nbourre/ranger_dropin/auriga/photos/PXL_20261021_132910721 (Custom).jpg

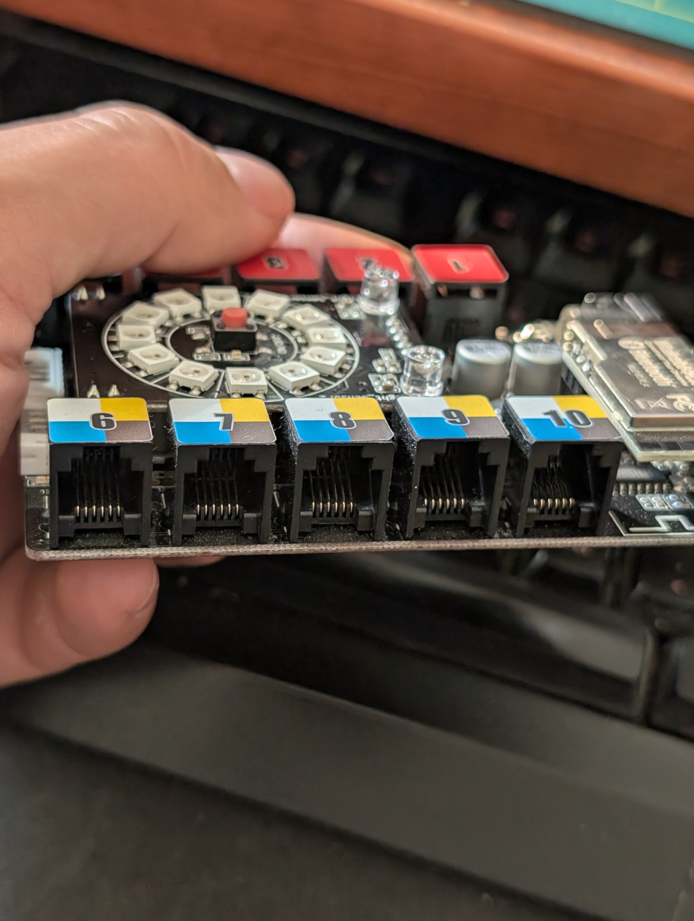
auriga/photos/PXL_20261021_132910721 (Custom).jpg
