nbourre/ranger_dropin/auriga/photos/PXL_20261021_135851345 (Custom).jpg

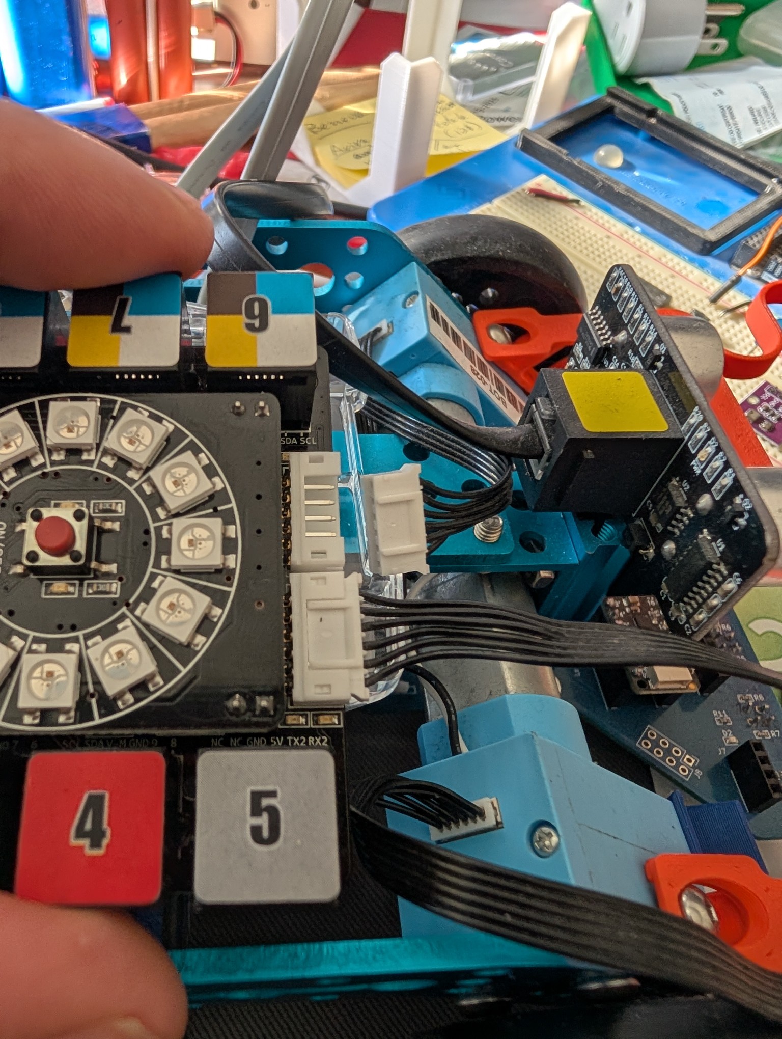
auriga/photos/PXL_20261021_135851345 (Custom).jpg
