nbourre/ranger_dropin/memoire/notes-a-faire.md

# À faire / en suspens (Beaper-Esp32s3, carrier DevKitC-1)

Dernière mise à jour : 2026-10-28 (soir). **L'état fait foi dans `MEMOIRE.md`, section « État (2026-10-28) »** ; les positions de la section « Disposition actuelle » ci-dessous datent du 2026-10-22 et sont en partie périmées (U5 tourné de 180° avec broche 1 à droite, J4/J8/SW1 déplacés, plus de bande de protections à la même place). Pour les positions réelles, lire la carte. Historique détaillé : `checkpoints/` (001 à 005, Copilot) et `git log`.

**Prochaine session, dans l'ordre** : (1) valider dans git l'état actuel (U5 2x22, modèles 3D, outils) ; (2) régler les conflits Q7/D13 et C7/Q5 et le courtyard H1/H4/H7/H8 ; (3) **routage** (lignes moteur 1 A, I2C, 5V_P, VCC) puis **zones de masse sans cuivre sous l'antenne du DevKit (x > 104)** ; (4) ERC/DRC finaux, BOM/LCSC, modèles 3D restants ; (5) demander à l'utilisateur de mettre à jour les 19 empreintes restantes depuis la bibliothèque dans KiCad (modèles 3D décochés, sans U5).

## État du projet
- **Schéma** : à jour (buck, fusibles séparés, protection des sorties moteur, décalage de niveau des RJ25, J1 jack DC, M1/M2 en JST PH, Qwiic J8 et 3 headers I2C J9/J15/J16). Dernier ERC complet : 0 erreur (avant les derniers ajouts, **à relancer**).
- **PCB** : 127 empreintes synchronisées avec le schéma, **tout sur la face du dessus (F.Cu)**, placement fait à la main par l'utilisateur et optimisé (condensateurs et résistances près de leurs broches). **Pas encore routé, pas de zone de masse, DRC non repris sur la version finale.** `score_placement` = 60 (les seuls « échecs durs » restants sont des chevauchements voulus avec le DevKit U5 et quelques courtyards d'en-têtes, voir plus bas).
- Contour 65,5 × 100 mm (R2) de (50, 30) à (115,5, 130), 3 trous de guidage Ø 2 mm (GH1 88,75/36 ; GH2 105,5/113,5 ; GH3 60/113,5).

## Disposition actuelle (positions clés, mm, repère PCB)
- Haut : J1 jack DC (57,75; 41,1), SW1 reset (66,1; 32,15), J12 panneau RGB 1x7 (75,13 à 90,37; 32,6, centré en x), buck U1 (79,65; 47,98) avec L1, C13/C14/C15/C16, compensation C19/C20/R42, diviseur R40/R41 ; U3 TB6612 (69,95; 57,26) ; J5 RJ25 A (110,52; 42,64, ouverture vers le haut).
- Milieu : J13/J14 appuis GND du panneau (66,875 et 98,625; 75,1), colonne de headers H7/H8/H4/H1 (x = 108,17; y 57,7 à 68,2), J9/J15/J16 I2C 1x04 (x = 105,63; y 72,6 à 79,8), LS1 buzzer, J3 TFT (52,25; 47,1), J11 OLED (52,25; 71,1).
- Bas : DevKit U5 (60,53; 107,28, rot 90, sur supports) avec les petits composants dessous (y 84 à 107), J4 et J8 Qwiic (111,25; 100,1 et 91,6, ouverture vers le bord droit, **sous le DevKit**), bande y 109 à 118 : chaînes de protection moteur et résistances d'encodeur, J10 VL53L1X (76,4 à 89,1; 119,6), M1 (70,25; 123,4) et M2 (85,25; 123,4) en JST PH, J6 et J7 RJ25 B et C dans les coins du bas (103,15 et 56,06; 117,71, ouverture vers le bas).
- Fixes (contraintes de l'utilisateur) : connecteurs moteur M1/M2 et capteur de distance J10 (J10 a été remonté de 4,2 mm pour les JST). Le module RGB doit rester centré en x.

## Décisions de conception (rappel)
- **Alimentation** : batterie NiMH 7,2 V sur J1 (centre = VBAT). VBAT → TVS D9 → F1 3,5 A → D8 → VCC (moteurs, VM du TB6612) et F2 3 A → D13 → buck U1 TPS54331 (5,0 V, même circuit que l'Auriga). D11 isole la sortie du buck (5V_P) du rail +5V (≈4,7 V) pour éviter le retour de courant USB. Servos : micro 9 g, 2 sorties (H7 = A6 / GPIO 6, H8 = A7 / GPIO 7) via le 74HCT541 U2 ; générer le PWM par LEDC.
- **Sorties moteur** : TB6612 → TVS bidirectionnelle SMAJ12CA (D14 à D17) → perle 120 Ω/2 A (FB1 à FB4) → PTC 1 A (F3 à F6) → M1/M2. Chaînes placées juste au-dessus de M1/M2.
- **M1/M2** : JST PH 6 broches, pas 2,0 mm, entrée latérale (S6B-PH-K, empreinte `Connector_JST:JST_PH_S6B-PH-K_1x06_P2.00mm_Horizontal`, modèle 3D de KiCad). Photos de l'Auriga dans `auriga/photos/`. Brochage : 1 ENCB, 2 ENCA, 3 +3V3, 4 GND, 5 M−, 6 M+. **Sens de la broche 1 à vérifier au multimètre sur une fiche moteur réelle.** Les encodeurs sont en 3,3 V (Auriga : 5 V) : à tester, sinon diviseur.
- **RJ25 (J5, J6, J7)** identiques à l'Auriga en tension (5 V) : 6 signaux S1/S2 par décalage de niveau BSS138 (Q3 à Q8, pull-ups 10 k R45 à R56), nets côté port `PA_S1_5V` etc., alimentation sur `5V_P` (sortie du buck avant D11). Ordre des broches du RJ : 1 SCL, 2 SDA, 3 GND, 4 5 V, 5 S1, 6 S2. Numérique seulement (pas d'analogique 0-5 V) ; le port B partage GPIO 43/44 (UART0) ; le port C partage D9/D10 avec J3. Prise : Amphenol 54601-906WPLF (6p6c, « tab down », contacts en haut ; l'Auriga est l'inverse, le câble se tord sans problème).
- **JP1** (header 1x03, « I2C EXT 3V3/5V ») : choisit la tension des pull-ups du bus I2C des RJ25 (EXT_SCL/EXT_SDA) : 1-2 = 3,3 V, 2-3 = 5 V (position Makeblock). Sans rapport avec le « JP1 » (jack d'alimentation) de `AURIGA_PINMAP.md`.
- **I2C 3,3 V du carrier** : Qwiic J4 et J8 (JST SH, GND/3V3/SDA/SCL), headers J9/J15/J16 (GND, +3V3, SCL, SDA, comme J11), H1 (SDA) et H4 (SCL), J10, J11, U6. Aucun pull-up ajouté pour les nouveaux connecteurs ; **vérifier que les pull-ups du bus principal (R16/R17 4,7 k) suffisent avec 8 appareils**.
- **74AHCT1G125 (U7)** : tampon 3,3 V → 5 V pour la donnée de l'anneau RGB : GPIO 48 → U7 → R39 220 Ω → J12.5. KEY du panneau : actif haut, R38 15 k / R37 10 k vers GPIO 14, sans pull-up interne.
- **Condensateurs** : replacés près de leur circuit (buck, U3, U2, U7, U4, U6, U5). C11 est collé à la broche VOL_BAT du DevKit. C8 (470 µF, VCC) est resté loin de U3.
- **Remplacements d'empreintes** pour gagner de la place : C7/C8/C17 en CP_Elec_6.3x7.7 (C5354997), C3 en 1206, U2 en TSSOP-20 (C53552921), U4 en SOT-23 (C127949).
- Supprimés : CON1 (bornier), H2/H3 (sonar), H5/H6, R13/R14, R27/R28, SW2 à SW5. Le Qwiic J9 de l'ancien schéma n'existe plus : **J9 est maintenant un header I2C 1x04**.

## À faire (priorité)
1. **Relancer ERC et DRC** sur le fichier enregistré. DRC connu : sérigraphie des références qui se chevauche partout (les masquer ou les réduire), espacement des pastilles du LSM6 (U6, 0,15 mm pour 0,2 mm requis, propre au composant), courtyards du DevKit (à ignorer ou exclure).
2. **Routage** (Freerouting ou à la main) : lignes moteur 1 A longues (U3 en haut, M1/M2 en bas, ~60 mm), I2C, 5V_P, VCC ; **zones de masse** F.Cu/B.Cu.
3. **Vérifications en 3D** (Alt+3) : RJ25 (ouverture qui dépasse du bord de ≈ 4,5 mm pour J5, J6 et J7, l'Auriga dépasse de ≈ 1,8 mm), Qwiic J4/J8 sous le DevKit (câble qui doit entrer sous le module), hauteur sous le DevKit (8,5 mm) et sous le module panneau, J12 contre GH1, buzzer LS1, SW1 (orientation du bouton latéral), J1 (sens d'entrée de la fiche).
4. **Modèles 3D** (état 2026-10-28) : U5 : modèle de l'utilisateur `3dmodels/ESP32-S3-DEVKITC-1-N8R8--3DModel-STEP-269445.STEP` (SolidWorks, mm, axe vertical = y, broches à x = ±11,43, z = −29,97 à 23,37, circuit y = 2,54 à 4,14, antenne côté z négatif) : rotation **x −90°** (le signe de KiCad est inversé : +90 donnait un modèle à l'envers), décalage **11,43 / −29,97 / 5,96** (dessous du circuit à 8,5 mm au-dessus de la carte) + deux supports `PinSocket_2x22_P2.54mm_Vertical` de KiCad aux décalages **0 et 25,4** (leur 2e colonne est vers les x négatifs). Validé par rendu 3D sur une carte d'essai (broches dans les supports, module côté broche 1, USB à l'autre bout). **Dans la bibliothèque seulement** : à copier sur la carte par « Mettre à jour les footprints depuis la bibliothèque » (option modèles 3D cochée) ou en les collant dans l'onglet 3D Models de U5. Les broches du modèle dépassent de 15 mm sous le circuit (plus long que les supports de 8,5 mm : c'est normal visuellement). L1 (Bourns SRP7028A) et SW1 (Alps SKRTLAE010) : KiCad ne fournit pas les fichiers que la carte référence ; blocs **approximatifs** générés par `tools/make_block_models.py` dans `3dmodels/*.wrl`, **pas encore assignés sur la carte** (propriétés du footprint, onglet Modèles 3D, échelle 1). À remplacer par les vrais STEP du fabricant. Reste sans modèle : G1 (logo) et GH1 à GH3 (trous, normal). Les autres empreintes ont un modèle de KiCad : si les modèles manquent après un rechargement, faire « Mettre à jour les empreintes depuis la bibliothèque » dans KiCad.
5. **Placement à revoir si le routage coince** : U3 plus près de M1/M2 ; D10 (diode du buck) à 4,8 mm de la broche PH de U1 (acceptable) ; C13 à 6 mm de VIN ; H1/H4/H7/H8 se touchent de 0,3 mm (courtyards) ; F6/LS1 1,2 mm² ; J12/GH1 2,8 mm² (pas de contact cuivre).
6. LCSC / BOM : refs manquantes (F1, D8, D9, C8, R31 à R39, R45 à R56 = 10 k C25804, C9 à C12, M1/M2 S6B-PH-K-S, U7, RJ25 54601-906WPLF, Qwiic, supports). L1 = HCMA-0630-6R8 (C54431702, Extended) à confirmer ; C7/C8/C17 470 µF C18221527 / C5354997 à confirmer.
7. Datasheet du LSM6DS3TR-C absent (st.com bloque le téléchargement automatique). Autres datasheets dans `datasheets/`.
8. Ménage du schéma : cadre pointillé « Optional 5V LDO » vide et périmé (x 25-86, y 150-193 mm) avec D1/R2 (LED Vin) ; commentaire 3 de la page de titre qui dit encore « Arduino Nano ESP32 ».
9. Confirmer le brochage du module OLED (J11 supposé GND, 3V3, SCL, SDA) et l'ordre des broches des modules I2C génériques (J9/J15/J16 sont GND, VCC, SCL, SDA).
10. Mesurer les trous de fixation Makeblock sur une vraie poutre (nominal 8 mm, M4).
11. **[Mise à jour 2026-10-28, soir : U5 tourné de 180° par l'utilisateur (rotation −90°, origine (113,87 ; 84,42), broche 1 à DROITE) pour que les USB soient à gauche (x ≈ 52,1, dans la carte) et l'antenne dépasse à droite (≈ 6 mm au-delà du bord) ; rangée L = nord (y 84,42, accès 81,88), rangée R = sud (y 107,28, accès 109,82). Étiquettes de broches refaites (44, y = 87,0 et 104,8). Les pièces liées aux GPIO sont à replacer par l'utilisateur.]** **[FAIT 2026-10-28 : footprint, schéma et carte à jour, cavaliers actifs sur la carte (`duplicate_pad_numbers_are_jumpers yes`), DRC non routés revenus à 304 ; pièces replacées par l'utilisateur ; il reste seulement à décider si on étiquette les rangées d'accès]** Historique : footprint créé : `BEAPER-Nano:ESP32-S3-DevKitC-1-2x22`** (88 pastilles, rangée d'accès **à l'extérieur** à x = −2,54 et 25,4 dans le repère du footprint, c'est-à-dire y = 109,82 et 81,88 mm sur la carte avec U5 en (60,53 ; 107,28) rot 90 ; même numéro de pastille que la broche du DevKit ; courtyard 30,6 × 56 mm). **Reste** : (1) cocher « Les numéros de pastille en double sont des cavaliers » (*duplicate_pad_numbers_are_jumpers*) dans les propriétés du footprint, Konnect ne peut pas l'écrire ; (2) changer le champ Footprint de U5 dans le schéma (le schéma doit être fermé dans l'éditeur) ; (3) mettre à jour le PCB depuis le schéma (dry-run d'abord) ; (4) l'utilisateur replace les pièces autour de la nouvelle rangée (la rangée sud tombe sur la bande des protections moteur, la rangée nord près de J9/J13/J14) ; (5) refaire les étiquettes des broches si besoin. Demande d'origine : **Monter le DevKit (U5) sur des headers femelles « doubles » : 2x22 au lieu de 1x22 par côté** (demande de l'utilisateur, 2026-10-22, à faire **avant** la tâche 12). Chaque côté du DevKit aurait donc deux rangées de 22 contacts femelles à 2,54 mm : une rangée reçoit les broches du DevKit, l'autre rangée, reliée broche à broche en parallèle, donne accès à **toutes** les broches (mesure, fils Dupont, autres variantes, GPIO non câblés). Pistes à étudier : (a) une empreinte U5 personnalisée (p. ex. `BEAPER-Nano:ESP32-S3-DevKitC-1-2x22`) avec deux pastilles du même numéro par broche, pour ne pas toucher au schéma, ou deux `PinSocket_2x22_P2.54mm_Vertical` ; (b) rangée supplémentaire **à l'extérieur** (côté bord de la carte), pour ne pas manger la zone entre les rangées où passent les petits composants ; (c) vérifier la largeur : DevKit 22,86 mm + 2 × 2,54 mm de rangée supplémentaire, sur une carte de 65,5 mm, et le chevauchement avec J3/J11 (x ≈ 52 mm) et la colonne H (x ≈ 105-113 mm) ; (d) la hauteur sous le module panneau (limite ≈ 8,5 mm sous le DevKit, à revalider) ; (e) les pastilles de la rangée supplémentaire doivent avoir un net (celui de la broche), même si elles ne vont nulle part ailleurs. Si toutes les broches sont accessibles ainsi, la tâche 12 devient en grande partie inutile.
12. **Ajouter des headers de sortie pour les GPIO 35, 36 et 37** (demande de l'utilisateur, 2026-10-22). Ces trois broches sont réservées par la **PSRAM octale** (« R8 ») : c'est le type de PSRAM qui compte, pas la taille de la mémoire. La taille de la flash (N8 ou N16) ne libère aucune broche.

    | Variante du DevKitC-1 (même empreinte) | Flash | PSRAM | GPIO 35/36/37 |
    |---|---|---|---|
    | N16R8 (celle de la carte) | 16 Mo | 8 Mo octale | réservés |
    | N8R8 | 8 Mo | 8 Mo octale | réservés |
    | N8R2 | 8 Mo | 2 Mo quad | libres |
    | N8 / N4 | 8 ou 4 Mo | aucune | libres |

    Les flash octales (type N32R8V) en réservent encore plus. Tableau tiré de mes connaissances du module : **à confirmer** dans la fiche d'Espressif (WROOM-1, tableau des broches) et `datasheets/U5_ESP32-S3-DevKitC-1_schematic.pdf`. À faire : un header 1x03 (GPIO 35/36/37) avec les nets nommés, non câblés à autre chose, marqué « sans PSRAM octale seulement » en sérigraphie (inutile avec un N16R8 ou un N8R8) ; mettre à jour le tableau GPIO du README si on les utilise.
13. Optionnel : MCP23017 si plus de GPIO ; firmware : GPIO 14 (KEY) en entrée sans pull-up interne, actif haut ; module suiveur de ligne I2C maison (ATtiny1616 seesaw, adresse 0x49) sur un Qwiic.

## Améliorations à regarder plus tard
- **Remplacer les 6 canaux BSS138 des RJ25 (Q3 à Q8, pull-ups R45 à R56) par un TXS0108EPW** (demande de l'utilisateur, 2026-10-28). Gain : 18 composants (6 FET + 12 résistances) remplacés par 1 TSSOP-20 + 2 condensateurs de découplage ; 8 canaux, donc 2 de réserve ; A = 3,3 V (1,65 à 3,6 V), B = 5V_P (2,3 à 5,5 V). Réserves (tiré de mes connaissances du composant, **à confirmer dans la fiche TI**) : (a) pas de pull-ups sous ≈ 50 kΩ avec le TXS (les 10 k disparaîtraient) ; (b) la détection automatique de direction peut mal gérer les capteurs Makeblock bidirectionnels sur une seule broche (ultrason) ou à collecteur ouvert, là où BSS138 + pull-ups sont fiables ; (c) risque de parasites ou d'oscillations avec la capacité des câbles RJ25 ; (d) broche OE à contrôler (basse à la mise sous tension), VCCA ≤ VCCB en tout temps. À tester avec les capteurs réels avant de s'engager. Le bus I2C EXT (JP1) est séparé et ne serait pas touché.

## Pièges Konnect appris
- Voir `MEMOIRE.md`, section « Particularités des outils Konnect ».
