nbourre/ranger_dropin/memoire/checkpoints/001-auriga-motor-power-comparison.md

<overview>
The user is converting a KiCad 10 project (BEAPER Nano, a mirobo.tech educational robot board) from through-hole to SMD parts, using JLCPCB/LCSC Basic parts where possible. The final board will be a carrier for an **ESP32-S3-DevKitC-1-N16R8** that replaces the Makeblock mBot Ranger's Arduino "Auriga" controller. The user's latest request (in French) is to make sure the motor power available on the Beaper is **at least similar to the Auriga's**. I'm comparing the two schematics and am about to swap the motor driver in the schematic. The PCB layout is deferred until the user provides dimensions. The user writes in French, so reply in French.
</overview>

<history>
1. The user asked for help with the Konnect MCP configuration and attached `file_mcp.json`.
   - The file registers `KiCAD-MCP-Konnect` as a stdio server at `C:\Users\nicol\OneDrive\Documents2\KiCad\10.0\3rdparty\plugins\com_github_mixelpixx_konnect\bin\konnect.exe`.
   - I confirmed Konnect responds (v0.13.0, KiCad CLI 10.0.7, IPC socket available).
   - Via `load_toolset` I loaded all 21 toolsets (228 tools).
   - I explained that Konnect's Claude skill files in `~/.claude` are not auto-installed for Copilot; I use the MCP tools directly.

2. The user asked to replace the through-hole parts with Basic SMD parts, schematic first, PCB dimensions later. The goal is to replace the Arduino Auriga with an ESP32-S3.
   - I inspected the project: 140 components.
   - I asked clarifying questions. The user's answers:
     - Ignore the ESP32-S3 for now and migrate the simple components to SMD.
     - Keep all original functionality.
     - Basic parts preferred.
     - Keep THT connectors.
     - The target is a carrier board for the DevKitC-1-N16R8.
   - I downloaded the JLCPCB parts database to `C:\Users\nicol\AppData\Local\Temp\konnect-jlcpcb-parts.sqlite` (Konnect's own search tool reports no DB path configured in `settings.json`). I checked Basic availability, then deleted the DB.
   - I used `batch_edit_schematic_components` to set footprints in `BEAPER-Nano.kicad_sch`:
     - R1–R30 → `Resistor_SMD:R_0603_1608Metric`
     - C4, C5, C6 (100 nF) → `Capacitor_SMD:C_0402_1005Metric`
     - D1–D5 → `LED_SMD:LED_0603_1608Metric`
   - Verified: 140 components preserved, all pin-to-net mappings identical, 38/38 footprints applied.
   - Left the 10 µF polarized caps (C1, C2, C3, C7) THT because of LM2940 stability concerns. D6/D7 (5 mm LEDs), Q1–Q4 (optical), SW1–SW5, RV1/RV2, JP1–JP4, buzzer, all headers/CON1, U1 (TO-220), U2 (DIP-20), U3 (DIP-16), U4 (TO-92) are all still THT.
   - Basic-part findings:
     - 0603 Basic resistors exist for 100R (C22775), 270R (C22966), 1k (C21190), 4.7k (C23162) and 10k (C25804).
     - 5.62k (C2930113 / C23188) and 1.37k (C2933142 / C22839) are Extended only.
     - 100 nF 0402 X7R: C1525 (16 V) or C307331 (50 V).
     - LED KT-0603R is C2286.
     - 10 µF options: 0603 C19702 (Basic), 0805 C15850 (Basic).

3. The user said they added the Auriga schematic and asked (in French) to make sure the Beaper's motor power is at least similar to the Auriga's.
   - Found `Me Auriga Schematic.pdf` in the project root (1 page, 842×595 pt). I extracted the text and rendered crops with PyMuPDF to `…\session-state\…\files\auriga_motor.png`, `auriga_power_a.png` and `auriga_power_b.png`.
   - Analysed the Beaper motor circuit by exporting a netlist (`files\beaper.net`) and a render (`files\beaper_before.png`).
   - Backed up the current schematic to `C:\Users\nicol\.copilot\session-state\41f4b332-d886-444f-8613-d4b14432f684\files\BEAPER-Nano.kicad_sch.before-tb6612`.
   - Re-downloaded the JLC DB (temp path above; it must be deleted again) and confirmed TB6612FNG availability.
   - Was in the middle of planning the U3 replacement when compaction occurred. **No U3-swap edits have been made yet.**
</history>

<work_done>
Files modified:
- `D:\_data\projets\_cegep\1sx\ranger_dropin\BEAPER-Nano.kicad_sch`: footprint changes only, as listed in the history.

Files created (session artifacts, in `C:\Users\nicol\.copilot\session-state\41f4b332-d886-444f-8613-d4b14432f684\files\`):
- `BEAPER-Nano.kicad_sch.before-tb6612` (backup)
- `beaper.net`
- `beaper_before.png`
- `auriga_motor.png`
- `auriga_power_a.png`
- `auriga_power_b.png`

Temp file to delete: `C:\Users\nicol\AppData\Local\Temp\konnect-jlcpcb-parts.sqlite` (~335 MB).

Work completed:
- [x] Konnect access verified and all toolsets loaded
- [x] Passive/LED footprints migrated to SMD in the schematic
- [x] Auriga motor and power section analysed
- [x] Beaper motor driver wiring traced from the netlist
- [x] TB6612FNG symbol and JLC part located
- [ ] Replace U3 (SN754410, DIP-16) with a TB6612FNG in the schematic (planned, not started)
- [ ] Delete the temp JLC DB
- [ ] Report findings to the user in French (comparison, change made, caveats)

Pre-existing uncommitted git changes that are not mine: `BEAPER-Nano.kicad_pcb` (modified, currently open in KiCad), `BEAPER-Nano.kicad_pro`, `.mcp.json`, `.vscode/`.
</work_done>

<technical_details>
**Auriga motor section (from PDF):**
- Driver is a Toshiba **TB6612** (U4).
  - VM pins 13, 14 and 24.
  - Logic VCC is 5 V.
  - STBY, PWMA and PWMB are driven by the MCU (EN_PWMA/B, EN_DIRA1/2, EN_DIRB1/2).
  - Outputs AO1/AO2 and BO1/BO2 go to M1+/M1−/M2+/M2−.
- Motor supply `V-M` comes from V-BAT through diode D06 (SS54) and fuse F02 (3.5 A). Each motor output has a 1 A fuse (F3, F4) and BEAD,2A filters.
- SMAJ12A TVS diodes are on the motor outputs. A SMAJ13A TVS is on the battery input.
- VM bulk capacitance: 470 µF/16 V plus 10 µF and 100 nF caps.
- Main V-BAT input has a 1.5 A fuse (F1) and an SS34 diode.
- 5 V comes from a TPS54331 buck converter.

**TB6612FNG characteristics:**
- 1.2 A continuous / 3.2 A peak per channel.
- About 0.5 Ω total on-resistance, so roughly 0.5 V drop at 1 A.
- VM range 4.5–13.5 V.
- Logic VCC 2.7–5.5 V.

**Beaper motor section (from netlist and render):**
- U3 = SN754410NE:
  - Pin 8 (VCC2) = net `VCC` (battery, labelled "6–12 V" on CON1); pin 16 (VCC1) = `+5V` (from the LM2940 U1).
  - Pins 1 and 9 (enables) are tied together and pulled to +5V via R19 (10k), so always enabled; there is no PWM-on-enable.
  - Inputs 1A–4A (pins 2, 7, 10, 15) come from 74HCT541 (U2) outputs Y4–Y7, which come from D4–D7.
  - Outputs 1Y–4Y (pins 3, 6, 11, 14) go to CON1 pins 3–6 (M1A, M1B, M2A, M2B).
  - GND on pins 4, 5, 12 and 13.
  - CON1: pin 1 = VCC, pin 2 = GND.
  - There is no fuse, reverse-polarity diode or TVS, and only 2× 10 µF polarized caps on VCC.
- The SN754410 is rated 1 A continuous / 2 A peak per bridge, but it is a bipolar driver with about 1.4 V (source) + 1.2 V (sink) ≈ 2.6 V typical drop at 1 A (up to about 3.6 V). At a 7.4 V battery that leaves about 4.8 V at the motor versus about 6.9 V with the TB6612. It also dissipates about 2.6 W per bridge, so it is clearly weaker and hotter than the Auriga's.

**Planned fix (U3 → TB6612FNG):**
- Symbol: `Driver_Motor:TB6612FNG`, footprint `Package_SO:SSOP-24_5.3x8.2mm_P0.65mm`, JLC part C141517 (Extended, about $1.15, 3,100+ in stock; C88224 is an alternate SSOP-24).
- Symbol pin offsets (symbol y is up, schematic y is down):

| Pin | x offset | y offset |
|---|---|---|
| AIN1 | −15.24 | −2.54 |
| AIN2 | −15.24 | −5.08 |
| BIN1 | −15.24 | −7.62 |
| BIN2 | −15.24 | −10.16 |
| PWMA | −15.24 | +5.08 |
| PWMB | −15.24 | +2.54 |
| STBY | −15.24 | +10.16 |
| AO1 | +15.24 | +10.16 |
| AO2 | +15.24 | +5.08 |
| BO1 | +15.24 | −2.54 |
| BO2 | +15.24 | −7.62 |
| VM1/VM2/VM3 | +2.54 / +5.08 / +7.62 | +25.4 (top) |
| VCC | −7.62 | +25.4 (top) |
| PGND1 | +2.54 | −25.4 (bottom) |
| PGND2 | +7.62 | −25.4 (bottom) |
| GND | −7.62 | −25.4 (bottom) |

- Pins 1/2, 3/4, 5/6, 7/8, 9/10 and 11/12 are stacked duplicates at the same location.
- Mapping to preserve behaviour:
  - AIN1 ← Y4 (D4), AIN2 ← Y5 (D5), BIN1 ← Y6 (D6), BIN2 ← Y7 (D7).
  - AO1 → CON1.3, AO2 → CON1.4, BO1 → CON1.5, BO2 → CON1.6.
  - PWMA and PWMB tied to +5V.
  - STBY to the R19 pull-up net.
  - VCC = +5V; VM1/2/3 = `VCC` rail; GND/PGND1/PGND2 = GND.
- Behavioural difference to flag to the user: with both inputs low the TB6612 coasts (high-Z), while the SN754410 brakes. IN=H/H brakes on both.
- The TB6612 VM max is 13.5 V, so the supply must stay ≤ 12 V (the Beaper label says 6–12 V, which is OK). The SN754410 tolerated up to 36 V.
- Optional improvements to recommend (not necessarily implement): reverse-polarity SS54 (JLC Basic C22452), a 3.5 A fuse, SMAJ13A TVS (C19077533), and a 470 µF/16 V VM bulk cap, all to match the Auriga.

**Geometry plan for the swap** (schematic mm; sheet is size B and the motor block is a dashed box at roughly x 227–314, y 183–247):
- Old U3 center is (262.89, 223.52).
- Old input wires from U2 Y4–Y7 (starting at x=135.89) end at x=247.65 at y 218.44, 220.98, 228.6, 231.14, with intermediate jogs at x 231.14 and 233.68.
- Old output stubs end at x=278.13 and run to CON1 pins at x=290.83, y 220.98, 223.52, 226.06, 228.6.
- The VCC rail is at y=195.58; the +5V rail runs along y=195.58 from x 237–260.
- R19 is at (237.49, 200.66) with its enable bus down x=237.49.
- Wire UUIDs to delete (first 8 characters; full UUIDs come from `list_schematic_wires`):
  - input side: 2cb46060, 22d97baf, 2abbdc26, 84f44523, d2b3e968, 2506886c, b7d0d5e7, 698f16b4, c94594ca, 619f957e, 60bd4e13, d40c62d1
  - output side: dc6c2a71, 5197c9a3, 0b00909e, 4f70a452
  - power/GND stubs: 377177fa (old VCC2), 6ff15d8c (old VCC1), 3f83757f (old GND stub)
  - Also delete the GND power symbol at about (262.89, 238.76).
- Wires to keep: 25e7df82 and b84e747b (CON1 side), 4e18d0c2 and 4e96cad3 (straight output stubs to CON1.5 and CON1.6).
- Proposed placement: cx=260.35, cy=236.22.
  - VM2 lands at (265.43, 210.82), which reuses the existing VCC wire 377177fa up to the rail.
  - Tie VM1 and VM3 with a horizontal wire at y=210.82 from x 262.89 to 267.97.
  - The +5V wire for the VCC pin goes up at x=252.73 to the +5V rail at y=195.58, with a junction.
- The dashed "Optional robot motor driver" rectangle (bottom ≈ y 247) is too small. Either extend its bottom edge to about y 266 by editing the `(rectangle …)` entry in the .kicad_sch text, or accept overflow.
- Because the old wires are unnamed (`Net-(…)`), the simplest and cleanest wiring is net labels on matching wire/pin ends:
  - Labels for the outputs: M1A, M1B, M2A, M2B.
  - Labels for the inputs: e.g. M1_IN1, M1_IN2, M2_IN1, M2_IN2 (at the Y4–Y7 wire ends and at the TB6612 pins).
  - Label for STBY: e.g. MOTOR_STBY (at R19 pin 2 and at the STBY pin).
  - Use power symbols (`add_power_symbol`) for +5V (PWMA/PWMB, VCC) and GND, not local labels, to avoid the root-sheet "/" net-name prefix ambiguity.
- Add a custom field `LCSC = C141517` to the new U3.

**Konnect tool quirks:**
- Tools are deferred and must be surfaced via `tool_search_tool` before use. Just surfaced: `add_schematic_net_label`, `batch_delete`, `batch_connect_to_net`, `batch_delete_schematic_wire`, `delete_schematic_net_label`. Still to surface: `add_schematic_component`, `add_wire`, `add_power_symbol`, `add_junction`.
- `export_netlist_summary` reports unnamed nets as "~".
- `generate_netlist` (kicad-cli) produces real net names as `Net-(U3-…)`; its KiCad 10 format is multi-line and needs an S-expression parser (the regex attempt failed).
- `get_symbol_info` requires the `lib_id` argument.
- `download_jlcpcb_database` fails without `output_path` ("path not found"), so pass an explicit temp path.
- `search_jlcpcb_parts` won't use the downloaded DB because `jlcpcb_db_path` is empty in `settings.json`, so query the SQLite directly with Python. Table `components` has columns LCSC, MFR_Part, Package, Manufacturer, Library_Type (Basic/Preferred/Extended), Description, Datasheet, Price, Stock, Category. Print with `sys.stdout.reconfigure(encoding='utf-8')` because of the ℃/Ω characters.
- The PCB is open in KiCad (IPC active). Schematic file edits went through fine earlier.
- The user's default passives (Konnect config): 100 nF 0402, 10 µF 0805, 10k 0402 pull-up. Fab is JLCPCB, 2 layers, min trace/clearance 0.15 mm, min via drill 0.3 mm.

**Open questions and assumptions:**
- Actual battery voltage and motor stall current are unknown. I assume 6–12 V per the Beaper label, similar to the Auriga.
- The user said "basic preferred", so the TB6612's Extended status is an acceptable exception.
- The Beaper note says the 5 V rail from LM2940 (1 A) feeds U3/U2 logic; TB6612 logic current is negligible.
- PCB changes (footprint swap, trace widths ≥ ~1 mm for the motor/VCC path) are deferred until the user provides board dimensions.
</technical_details>

<important_files>
- `D:\_data\projets\_cegep\1sx\ranger_dropin\BEAPER-Nano.kicad_sch`
  - Main schematic (size B, 140 components) being migrated.
  - Footprints for R1–R30, C4–C6 and D1–D5 already changed to SMD.
  - Next: replace U3. The motor block is in the bottom-right dashed box (U3 center at 262.89, 223.52; CON1 at about 295.9, 220.98).
- `D:\_data\projets\_cegep\1sx\ranger_dropin\BEAPER-Nano.kicad_pcb`
  - Board, open in KiCad and modified by the user. Not touched; layout deferred.
- `D:\_data\projets\_cegep\1sx\ranger_dropin\Me Auriga Schematic.pdf`
  - Reference for the Auriga's TB6612 motor drive, fuses and power. The motor section is about x 60–500, y 430–560 and the power section about x 540–842, y 20–130 (PDF points).
- `C:\Users\nicol\.copilot\session-state\41f4b332-d886-444f-8613-d4b14432f684\files\` (session artifacts)
  - `BEAPER-Nano.kicad_sch.before-tb6612`: rollback backup.
  - `beaper.net`: netlist export.
  - `beaper_before.png`: render of the schematic before the swap.
  - `auriga_*.png`: Auriga crops.
- `D:\_data\projets\_cegep\1sx\ranger_dropin\.mcp.json` and `.vscode\mcp.json`
  - MCP server config (untracked).
</important_files>

<next_steps>
Remaining work:
1. Surface the remaining Konnect tools (`add_schematic_component`, `add_wire`, `add_power_symbol`, `add_junction`).
2. Perform the U3 swap in `BEAPER-Nano.kicad_sch`:
   - Delete U3 (`batch_delete` with `references: ["U3"]`).
   - Delete the listed stale wires and the GND power symbol at the old U3 position.
   - Place `Driver_Motor:TB6612FNG` as U3 at about (260.35, 236.22) with the SSOP-24 footprint and `LCSC = C141517`.
   - Wire or label it per the mapping above (inputs from Y4–Y7, outputs to CON1.3–6, VM to the VCC rail, VCC/PWMA/PWMB to +5V, STBY to R19, GND/PGND to GND).
   - Extend the dashed box if needed.
3. Verify with `generate_netlist` plus an S-expression parse: the 4 input nets, the 4 output nets to CON1, VM = `VCC`, logic VCC = `+5V`, all GNDs, and the STBY pull-up. Confirm no other component's nets changed, run `run_erc`, and render a PNG to check visually. If it goes wrong, restore from the `.before-tb6612` backup.
4. Delete `C:\Users\nicol\AppData\Local\Temp\konnect-jlcpcb-parts.sqlite`.
5. Reply to the user in French, concisely:
   - Auriga (TB6612, 1.2 A continuous, ~0.5 V drop, 1 A fuses) vs Beaper (SN754410, ~2.6 V drop, much less motor voltage and more heat).
   - The driver was replaced by the same chip as the Auriga, which is also SMD.
   - The brake-vs-coast difference.
   - The ≤12 V limit.
   - Optional protection (SS54, 3.5 A fuse, SMAJ13A, 470 µF bulk cap).
   - The PCB will need updating later (footprint, ≥1 mm motor traces).
   - Confirm the battery voltage and motor stall current.

Immediate next step: call `tool_search_tool` for `add_schematic_component`, `add_wire`, `add_power_symbol` and `add_junction`, then begin the deletion/placement sequence.
</next_steps>
