nbourre/ranger_dropin/memoire/checkpoints/002-swapping-nano-socket-for-esp32.md

<overview>
The user is converting a KiCad 10 project (BEAPER Nano, a mirobo.tech educational robot board) from through-hole to SMD parts, using JLCPCB/LCSC Basic parts where possible. The board becomes a carrier for an **ESP32-S3-DevKitC-1-N16R8** that replaces the Makeblock mBot Ranger's Arduino "Auriga" controller. I use the Konnect MCP tools (KiCAD-MCP-Konnect) to edit the schematic. The user writes in French, so reply in French, concisely. PCB layout is deferred until the user gives board dimensions.

The latest request is: "Es-tu capable de remplacer le footprint et le câblage par ce board?" The user attached a photo of the ESP32-S3-DevKitC-1 pinout. The aim is to replace the Arduino Nano ESP32 socket (J1/J2) in the schematic with this DevKitC-1 board, both the footprint and the wiring. I answered "yes" in principle and am partway through the work.
</overview>

<history>
1. **Konnect MCP configuration help.**
   - Verified Konnect works (v0.13.0, KiCad 10.0.7) and loaded all toolsets.

2. **Through-hole to SMD conversion, schematic first.**
   - The user answered my clarifying questions: ignore the ESP32 for now, keep all functionality, prefer Basic parts, keep THT connectors, target is a carrier board for the DevKitC-1.
   - Footprints set in `BEAPER-Nano.kicad_sch`: R1–R30 → R_0603; C4–C6 → C_0402; D1–D5 → LED_0603.
   - Still THT: 10 µF polarized caps (C1, C2, C3, C7), D6/D7, Q1–Q4, switches, pots, jumpers JP1–JP4, buzzer, headers, CON1, U1 (TO-220), U2 (DIP-20), U4 (TO-92).

3. **Motor power compared with the Auriga.**
   - Auriga uses a TB6612 (1.2 A continuous, ~0.5 V drop, 1 A fuses, 3.5 A fuse, SS54 diode, SMAJ TVS, 470 µF VM cap).
   - Beaper used an SN754410 (DIP-16): ~2.6 V drop, far weaker and hotter.
   - I replaced U3 with `Driver_Motor:TB6612FNG` (SSOP-24, LCSC C141517, Extended part).
   - I had to strip 78 stale `(project "ASRP100"` instance entries from the .kicad_sch with a Python script, because Konnect refused to edit the file otherwise.
   - U3 wiring is done with net labels and power symbols; the netlist was verified:
     - M1_IN1, M1_IN2, M2_IN1, M2_IN2 come from U2 pins 14, 13, 12, 11.
     - M1A, M1B, M2A, M2B go to CON1 pins 3–6.
     - MOTOR_STBY connects R19.2 to U3 STBY.
     - PWMA, PWMB and VCC are on +5V; VM1/2/3 are on VCC; GND pins are on GND.
   - The motor dashed box was extended (bottom edge 247.65 → 270.51).
   - The LCSC field `C141517` was added to U3.
   - Behaviour difference flagged to the user: with both inputs low the TB6612 coasts, the old part braked. Maximum supply is 13.5 V.

4. **Battery protection and USB charging.**
   - The user said the battery is a 7.2 V NiMH RC pack and wanted USB charging (can be independent), and agreed to the Auriga-style protection.
   - I added protection on the battery input: CON1.1 → F1 (fuse 3.5 A, 1206) → D8 (SS54, SMA) → VCC rail, D9 (SMAJ13A TVS, SMA) between CON1.1 side and GND, C8 (470 µF/16 V, CP_Elec_8x10.5) on VCC.
   - Two duplicate old D8/C8 components had to be deleted by editing the file text.
   - Netlist verified. ERC was NOT run.
   - I asked about USB charging. The user answered: **no on-board charger for now, drop it** (pack 3600 mAh, external charger).

5. **Current request: replace the Nano socket with the DevKitC-1 (footprint and wiring).** Progress is in `<work_done>`.
</history>

<work_done>
Files modified:
- `D:\_data\projets\_cegep\1sx\ranger_dropin\BEAPER-Nano.kicad_sch`: SMD footprints; U3 swapped to TB6612FNG with its wiring; F1, D8, D9, C8 added; ASRP100 instance entries removed.

Files created:
- `D:\_data\projets\_cegep\1sx\ranger_dropin\BEAPER-Nano.pretty\ESP32-S3-DevKitC-1.kicad_mod`:
  - 44 THT pads, 1.7 mm round with 1.0 mm drill.
  - Row L (J1 header, pads L1–L22 at x=0, y=0…53.34 in 2.54 mm steps; L1 is square) and row R (J3 header, R1–R22 at x=22.86).
  - Courtyard generated; pin 1 marked.
  - It is available as `BEAPER-Nano:ESP32-S3-DevKitC-1` (the BEAPER-Nano.pretty library is already registered in fp-lib-table).
- `D:\_data\projets\_cegep\1sx\ranger_dropin\ESP32S3.kicad_sym`: symbol `ESP32-S3-DevKitC-1` (44 passive pins, left side L1–L22 at x=-13.97, right side R1–R22 at x=+13.97, y = 0 down to -53.34 in 2.54 steps).
- Added `ESP32S3` to `sym-lib-table` (edited with the edit tool).

Session artifacts (`C:\Users\nicol\.copilot\session-state\41f4b332-d886-444f-8613-d4b14432f684\files\`):
- `BEAPER-Nano.kicad_sch.before-tb6612` (rollback backup)
- `beaper.net`, `beaper_before.png`
- `auriga_*.png`
- `after.png`, `now.png`, `now_nano.png`

Cleanup already done: the JLC DB temp file and the `after.net` / `after2.net` temp netlists are deleted. Leftover temp: `C:\Users\nicol\AppData\Local\Temp\pads.json` (harmless; delete).

**Not yet done for the DevKitC-1 swap:** the symbol is not placed, J1/J2 are not removed, and nothing is rewired. The schematic still has J1/J2 (Nano ESP32) as they were.

Untouched: `BEAPER-Nano.kicad_pcb` (open in KiCad, modified by the user, shows as modified in git), plus the untracked PDF and `.mcp.json`.
</work_done>

<technical_details>
**DevKitC-1 pinout (from the photo, antenna end = pin 1 of each row):**
- J1 row (symbol "L", bottom row in the photo): 
  - L1 3V3, L2 3V3, L3 RST, L4 GPIO4, L5 GPIO5, L6 GPIO6, L7 GPIO7, L8 GPIO15, L9 GPIO16, L10 GPIO17, L11 GPIO18, L12 GPIO8, L13 GPIO3, L14 GPIO46, L15 GPIO9, L16 GPIO10, L17 GPIO11, L18 GPIO12, L19 GPIO13, L20 GPIO14, L21 5V, L22 GND.
- J3 row (symbol "R", top row):
  - R1 GND, R2 GPIO43/TX, R3 GPIO44/RX, R4 GPIO1, R5 GPIO2, R6 GPIO42, R7 GPIO41, R8 GPIO40, R9 GPIO39, R10 GPIO38, R11 GPIO37, R12 GPIO36, R13 GPIO35, R14 GPIO0, R15 GPIO45, R16 GPIO48 (on-board RGB LED), R17 GPIO47, R18 GPIO21, R19 GPIO20, R20 GPIO19, R21 GND, R22 GND.
- Row spacing is 22.86 mm. Board size is approx 28 × 69 mm; the footprint only has the pad envelope as courtyard.
- GPIO to avoid: strapping 0, 3, 45, 46; USB 19, 20; flash/PSRAM 35–37 (N16R8 octal PSRAM); UART0 43/44 only for D0/D1.

**Existing schematic (Nano ESP32 socket):**
- J1 (Digital, 15 pins) at (45.72, 49.53); its pins are on the left at x=40.64, y=31.75…67.31 in 2.54 steps.
- J2 (Analog, 15 pins) at (60.96, 49.53); its pins are on the right at x=66.04, same y values.
- Each pin has a wire stub with a net label at its end. Left labels are at x=25.4 or 29.21, right labels at x=81.28 (A7, A6, A5/SCL, A4/SDA, A3, A2, A1, A0, BOOT0, D13/SCK, BOOT1, VBUS), plus D8 at 100.33.
- The 5 VCC/+3V3/GND power symbols are on the J2 side: VCC on J2.1 (VIN), +3V3 on J2.14, GND on J1.4 and J2.2, per the render.
- A blue rectangle with the text "Arduino Nano ESP32" surrounds J1/J2.

**Nets and where they connect:**
- J1 pins: 1 D1/TX0, 2 D0/RX0, 3 ~{RST}, 4 GND, 5 D2, 6 D3, 7 D4, 8 D5, 9 D6, 10 D7, 11 D8, 12 D9, 13 D10, 14 D11/COPI, 15 D12/CIPO.
- J2 pins: 1 VCC (VIN), 2 GND, 3 BOOT1, 4 VBUS, 5 A7, 6 A6, 7 A5/SCL, 8 A4/SDA, 9 A3, 10 A2, 11 A1, 12 A0, 13 BOOT0, 14 +3V3, 15 D13/SCK.
- Consumers:
  - U2 (74HCT541) inputs: A7→U2.2, A6→U2.3, A5/SCL→U2.4, A4/SDA→U2.5, D4→U2.6, D5→U2.7, D6→U2.8, D7→U2.9.
  - The buzzer is on D8.
  - A0–A3 go to jumpers JP1–JP4.
  - SPI header J3 uses D9, D10, D11, D12, D13, RST.
  - Qwiic J4 uses SDA/SCL and +3V3.
  - Switches SW2–SW5 use D0/RX0, D1/TX0, D2, D3 (labels in the lower area).
  - RST goes to SW1 via R1.
- BOOT0, BOOT1 and VBUS only appear on J2 (no other consumers), so they are dropped.
- Net labels in .kicad_sch use the "/" text; the netlist shows it as `{slash}`, with names like `/D1{slash}TX0`. Use the "D1/TX0" form when adding labels and verify by netlist afterward.

**Planned GPIO mapping (my own choice, keep the existing Arduino-style net names):**

| Net | GPIO | Pin |
|---|---|---|
| A0 | GPIO1 | R4 |
| A1 | GPIO2 | R5 |
| A2 | GPIO4 | L4 |
| A3 | GPIO5 | L5 |
| A6 | GPIO6 | L6 |
| A7 | GPIO7 | L7 |
| A4/SDA | GPIO8 | L12 |
| A5/SCL | GPIO9 | L15 |
| D2 | GPIO14 | L20 |
| D3 | GPIO15 | L8 |
| D4 | GPIO16 | L9 |
| D5 | GPIO17 | L10 |
| D6 | GPIO18 | L11 |
| D7 | GPIO21 | R18 |
| D8 | GPIO47 | R17 |
| D9 | GPIO38 | R10 |
| D10 | GPIO10 | L16 |
| D11/COPI | GPIO11 | L17 |
| D12/CIPO | GPIO13 | L19 |
| D13/SCK | GPIO12 | L18 |
| D1/TX0 | GPIO43 | R2 |
| D0/RX0 | GPIO44 | R3 |
| ~{RST} | RST (EN) | L3 |

- Power: 3V3 pins L1 and L2 → +3V3; 5V pin L21 → +5V (from LM2940 U1); GND pins L22, R1, R21, R22 → GND.
- DevKitC-1 has no VIN, so the +5V rail (U1 from the battery VCC) must now always be populated and powers the 5V pin. Flag to the user: with USB connected at the same time, the on-board diode isolates USB 5V, but the LM2940 output should not be back-fed (not fully verified).
- Unused GPIOs (0, 3, 19, 20, 35, 36, 37, 39, 40, 41, 42, 45, 46, 48) should get no-connect flags (add_no_connect) to avoid ERC pin_not_connected. These pins are typed `passive`.
- Place the new symbol as U5 (or reuse reference J1?), with footprint `BEAPER-Nano:ESP32-S3-DevKitC-1`, lib_id `ESP32S3:ESP32-S3-DevKitC-1`.
- Plan: delete J1, J2 and all attached wire stubs/labels/power symbols and the Nano rectangle/text. Then connect the new symbol's pins to the nets with `batch_connect_to_net` (stub_length 2.54, no wires needed) and power symbols (`add_power_symbol`) for +3V3/+5V/GND. Then verify with `generate_netlist` plus a Python parser that every consumer net (U2, J3, J4, JP1–4, LS1, switches, R1) still lands on the right DevKit pin.

**Konnect tool quirks learned:**
- Tools must be surfaced via `tool_search_tool` first. Already surfaced and usable: add_schematic_component, add_power_symbol, add_wire, batch_delete, batch_delete_schematic_wire, batch_connect_to_net, add_schematic_net_label, add_no_connect, create_footprint, create_symbol, list_schematic_components, get_schematic_pin_locations, batch_get_schematic_pin_locations (param `references`), edit_schematic_component (param `fields`), move_schematic_component, generate_netlist (param `output`), render_schematic_png (param `output`), list_schematic_labels, list_schematic_wires, render, search_symbols/search_footprints. `delete_schematic_component` and `register_symbol_library` were not surfaced (I edited sym-lib-table directly).
- Konnect refuses edits (stale_target) when KiCad has the schematic open in its editor. The user must close the schematic editor first (they did once); it may need to be closed again.
- Konnect also refuses edits if the project/instance metadata is stale (it requires exactly one instance `[BEAPER-Nano:/e63e39d7-…]`); I fixed that earlier by removing ASRP100 entries.
- `batch_delete` by reference fails with `ambiguous_target` if two components share a reference; delete by UUID, and as a last resort edit the file text.
- Do not use kicad-cli directly (not in PATH); use the `generate_netlist` tool. The KiCad 10 netlist is multi-line; parse with `re.split(r'\n\t\t\(net\n', t)` and `re.findall(r'\(ref "([^"]+)"\)\s*\(pin "([^"]+)"', n)`.
- list tools write large outputs to a temp file. Use Python to filter them.
- The PCB is open in KiCad (IPC active) and was not modified.

**Other open points:**
- LCSC refs for F1, D8, D9, C8 not set; the 470 µF cap probably isn't in JLC stock. The ERC has not been run on the whole schematic.
- 5.62k and 1.37k resistors are Extended-only.
- The SS54 drops ~0.4 V on the motor rail (fine for 7.2–8.4 V NiMH).
</technical_details>

<important_files>
- `D:\_data\projets\_cegep\1sx\ranger_dropin\BEAPER-Nano.kicad_sch`
  - Main schematic, size B; the Nano socket J1/J2 is at top-left (x ~25–100, y ~30–70), the motor block bottom-right (x 227–314, y 183–270).
  - Next edit: remove J1/J2 and wire the DevKitC-1.
- `D:\_data\projets\_cegep\1sx\ranger_dropin\ESP32S3.kicad_sym` and `sym-lib-table`: new symbol library (registered as `ESP32S3`).
- `D:\_data\projets\_cegep\1sx\ranger_dropin\BEAPER-Nano.pretty\ESP32-S3-DevKitC-1.kicad_mod`: new footprint.
- `D:\_data\projets\_cegep\1sx\ranger_dropin\BEAPER-Nano.kicad_pcb`: the board, still holding the old footprints (J1/J2, U3 DIP, etc.). The PCB update is deferred until the user gives dimensions; it is open in KiCad with user changes.
- `D:\_data\projets\_cegep\1sx\ranger_dropin\Me Auriga Schematic.pdf`: reference for the Auriga motor/power circuit.
- Session `files\` folder: backup `BEAPER-Nano.kicad_sch.before-tb6612`, plus netlist `beaper.net` (pre-ESP32 reference for net membership) and render PNGs.
</important_files>

<next_steps>
Remaining work:
1. Ask the user to close the schematic editor if Konnect reports `stale_target`.
2. Collect the UUIDs of the wires and labels attached to J1/J2 (pin x=40.64 and x=66.04, label x=25.4/29.21/81.28/100.33; the wire list is saved in a temp file from `list_schematic_wires`; labels from `list_schematic_labels`), and the power symbols on J1/J2 (VCC at J2.1, +3V3 at J2.14, GND at J1.4 and J2.2). Check the SW2–SW5 and other labels in the lower area belong to other circuits and must be kept. Delete J1, J2, those wires, labels and power symbols, and optionally the "Arduino Nano ESP32" rectangle and text (edit the file text for graphics).
3. Place `ESP32S3:ESP32-S3-DevKitC-1` with footprint `BEAPER-Nano:ESP32-S3-DevKitC-1` in the freed space (about x 40–100, y 30–90; the symbol is ~28 mm wide and ~58 mm tall, pins at ±13.97, y 0 to -53.34, so it may need to be placed lower or rotated).
4. Connect the pins with `batch_connect_to_net` per the GPIO mapping above; add +3V3, +5V and GND power symbols; add no-connect flags to unused GPIO pins; set the value `ESP32-S3-DevKitC-1-N16R8`; add the LCSC/notes field if desired.
5. Verify with `generate_netlist` plus a parser (all consumer nets, power nets and the old M1/M2 nets intact; no leftover references to J1/J2), render a PNG to check visually, and optionally run `run_erc`.
6. Clean up `C:\Users\nicol\AppData\Local\Temp\pads.json` and any temp netlists.
7. Reply to the user in French, concisely:
   - What was replaced (new custom symbol and footprint, GPIO mapping table, strapping/PSRAM pins avoided, power wiring via +5V and the LM2940 now required, 3V3 from the DevKit).
   - Caveats: the PCB is not updated yet (needs update from schematic once dimensions are given; the footprint's outline is approximate); the 5V back-feed with USB connected; the net names remain Arduino-style.
   - Open items: LCSC refs for the new protection parts, ERC.
</next_steps>
