nbourre/ranger_dropin/memoire/checkpoints/003-adding-battery-voltage-monitor.md

<overview>
The user is converting a KiCad 10 project (BEAPER Nano, a mirobo.tech educational robot board) from through-hole to SMD parts, using JLCPCB/LCSC Basic parts where possible. The board becomes a carrier for an **ESP32-S3-DevKitC-1-N16R8** that replaces the Makeblock mBot Ranger's Arduino "Auriga" controller. I edit the schematic with the Konnect MCP tools (KiCAD-MCP-Konnect). The user writes in French, so I reply in French and concisely, **except the README, which is in English at the user's request**. PCB layout is deferred until the user gives board dimensions.

I am partway through the latest request: add a battery-voltage monitor, because the Auriga has one on A4 (`A4/VOL_BAT`).
</overview>

<history>
1. **Konnect MCP configuration help.**
   - Verified Konnect works (v0.13.0, KiCad 10.0.7).

2. **Through-hole to SMD conversion, schematic first.**
   - Footprints set: R1–R30 → R_0603; C4–C6 → C_0402; D1–D5 → LED_0603.
   - Still THT: polarized 10 µF caps C1, C2, C3, C7, D6/D7, Q1–Q4, switches, pots, jumpers, buzzer, headers, CON1, U1 (TO-220), U2 (DIP-20), U4 (TO-92).

3. **Motor power compared with the Auriga.**
   - U3 SN754410 replaced by `Driver_Motor:TB6612FNG` (LCSC C141517, Extended). Wired with net labels and verified by netlist.
   - Removed 78 stale `ASRP100` instance entries so that Konnect would accept edits.

4. **Battery protection.**
   - CON1.1 → F1 (3.5 A) → D8 (SS54) → VCC. D9 (SMAJ13A TVS) to GND. C8 (470 µF) on VCC.
   - The user chose no USB charger.

5. **Replaced the Nano ESP32 socket (J1/J2) with the DevKitC-1.**
   - I deleted J1/J2, their wires, labels, power symbols and the blue rectangle, using a Python text edit plus `batch_delete_schematic_wire`.
   - I placed U5 (`ESP32S3:ESP32-S3-DevKitC-1`, footprint `BEAPER-Nano:ESP32-S3-DevKitC-1`, value `ESP32-S3-DevKitC-1-N16R8`) and connected its pins with `batch_connect_to_net`.
   - Added no-connects on the unused GPIO.
   - Verified by netlist: all consumer nets are intact.

6. **ERC.**
   - First run: 3 errors (undriven power pins).
   - I added 3 PWR_FLAG symbols at (265.43,191.77), (109.22,161.29) and (123.19,247.65).
   - Result: 0 errors.

7. **Added motor connectors M1/M2 (MHDR1X6 as on the Auriga).**
   - M1 and M2 are `Connector_Generic:Conn_01x06` with `PinHeader_1x06_P2.54mm_Vertical`.
   - Pinout for each:
     - pin 6: motor+ (M1A/M2A)
     - pin 5: motor− (M1B/M2B)
     - pin 4: GND
     - pin 3: +3V3
     - pin 2: encoder A
     - pin 1: encoder B
   - R31–R34 (51 Ω, 0603) sit in the encoder signal lines.
   - Encoders: ENC1A→GPIO39 (R9), ENC1B→GPIO40 (R8), ENC2A→GPIO41 (R7), ENC2B→GPIO42 (R6).
   - Encoders are powered at 3.3 V (the Auriga uses 5 V); this still has to be tested.
   - I deleted the no-connects that were on R6–R9.

8. **Q&A (answered in French).**
   - The 5 V LDO is required, because the DevKitC-1 has no VIN.
   - For a pan/tilt with 2 servos, a 5 V / 3 A buck is needed. The user said to keep this in memory, and I saved it in `files\notes-a-faire.md`.

9. **Auriga vs Beaper feature review.**
   - I read the PDF as text with PyMuPDF (extracted to `%TEMP%\aur.txt`).
   - Missing on the new board:
     - 12-LED RGB ring (`D44/RGB`)
     - MIC with LM2904
     - LIGHT2
     - RJ25 ports
     - power switch
     - battery voltage sensing (see item 14)
   - Beaper-only: TFT/SPI connector J3, Qwiic J4, line/floor sensors, H1–H8, RV1/RV2, JP1–JP4, 4 buttons, 4 LEDs.

10. **Added an IMU.**
    - The user asked for an accelerometer of similar or better quality in the same price range, available at JLCPCB.
    - I chose the **LSM6DS3TR-C** (LCSC C967633, about 1.58 $ US, 14k in stock, not Basic). Alternatives: QMI8658A, ICM-42607-C, BMI260.
    - The first attempt failed because the KiCad editor had the file locked. The user closed it.
    - My first placement overlapped the left-floor-sensor block and merged Q1 with +3V3.
    - I removed it by text edit (components, labels, junctions, no-connects), then changed the page to **size C** (559×432 mm) with `set_schematic_page`.
    - Final placement of U6, C9 and C10 is at about x=470, y=100:
      - VDD, VDDIO and CS are on +3V3.
      - SDO/SA0 and GND are on GND (I2C address 0x6A).
      - SDA = A4/SDA (GPIO8), SCL = A5/SCL (GPIO9).
      - INT1, INT2, SDX, SCX and the 2 NC pins have no-connects.
      - C9 and C10 are 100 nF, 0402.
      - LCSC field C967633 is on U6.
    - ERC: 0 errors, 83 warnings.
    - Netlist comparison with the previous state confirmed no other net changed.

11. **Remaining GPIO.**
    - Free: 48 (also the on-board RGB LED), 45/46/3/0 (strapping), 19/20 (USB D−/D+).
    - 35/36/37 are used by the octal PSRAM.

12. **Buttons.**
    - SW2→D0/RX0 (GPIO44, R3), SW3→D1/TX0 (GPIO43, R2), SW4→D2 (GPIO14, L20), SW5→D3 (GPIO15, L8). SW1 goes through R1 to EN (L3).
    - Each button has a 1 kΩ resistor (R3–R6). I did not check the pull-up/pull-down direction.

13. **README.**
    - I first started reading the instruction file for French markdown. The user then said "Fais le en anglais stp".
    - I created `D:\_data\projets\_cegep\1sx\ranger_dropin\README.md` in English. It has four sections: Auriga features, BEAPER-on-ESP32-S3 features with the GPIO map, a comparison, and open items.

14. **Latest request: "On A4 there's a power sensor on the auriga".**
    - I confirmed it in the PDF: `A4/VOL_BAT` is a battery voltage divider, R58 100 kΩ / R59 51 kΩ, plus C48 1 µF, from V-BAT.
    - Voltage sensing, not current.
    - On the Beaper, A4 is SDA, so I decided to use **GPIO3 (L13, ADC1_CH2)**, the only free ADC1 pin.
    - I explained this to the user in a message before starting.
    - I deleted the no-connect at U5 L13 (46.99, 58.42).
    - I added R35 (100k, 0603) at (439.42,160.02), R36 (51k, 0603) at (454.66,160.02) and C11 (1 µF, 0402) at (469.9,160.02).
    - **None of the three is wired yet.**
</history>

<work_done>
Files modified or created:
- `BEAPER-Nano.kicad_sch`: all changes above; page size now C; contains U5, U6, U3, M1, M2, F1, D8, D9, C8–C11, R31–R36.
- `BEAPER-Nano.pretty\ESP32-S3-DevKitC-1.kicad_mod` (created): 44 THT pads, 1.7 mm round / 1.0 mm drill, rows L and R 22.86 mm apart, courtyard is the pad envelope only.
- `ESP32S3.kicad_sym` (created) and an `ESP32S3` entry in `sym-lib-table`.
- `README.md` (created, English).
- Session `files\`: `notes-a-faire.md`, plus netlists `after3.net` … `after9.net` and render PNGs `now2.png` and `now3.png`.

Done:
- [x] SMD footprints
- [x] TB6612 driver
- [x] Battery protection
- [x] DevKitC-1 swap
- [x] M1/M2 connectors
- [x] IMU
- [x] ERC 0 errors (83 old library warnings)
- [x] README

In progress:
- [ ] Battery voltage monitor: R35, R36 and C11 are placed but not wired. U5 L13 no-connect was removed.

Not done:
- [ ] PCB update (`BEAPER-Nano.kicad_pcb` is still the old board; it is open in KiCad with user changes).
- [ ] LCSC refs for F1, D8, D9, C8, R31–R36, C9–C11, M1/M2 (and C8 is probably not in stock).
- [ ] Buck 5 V / 3 A replacing U1 (LM2940).
- [ ] Update README for the new VOL_BAT function (GPIO3, R35/R36/C11), the missing-functions list and the GPIO table.
- [ ] Title block comment 3 still says "for Arduino Nano ESP32".

The `%TEMP%\aur.txt` file is left over; delete it at cleanup.
</work_done>

<technical_details>
**DevKitC-1 pinout (symbol "L" row = J1, "R" row = J3):**
- L1 3V3, L2 3V3, L3 RST, L4 GPIO4, L5 GPIO5, L6 GPIO6, L7 GPIO7, L8 GPIO15, L9 GPIO16, L10 GPIO17, L11 GPIO18, L12 GPIO8, L13 GPIO3, L14 GPIO46, L15 GPIO9, L16 GPIO10, L17 GPIO11, L18 GPIO12, L19 GPIO13, L20 GPIO14, L21 5V, L22 GND.
- R1 GND, R2 GPIO43, R3 GPIO44, R4 GPIO1, R5 GPIO2, R6 GPIO42, R7 GPIO41, R8 GPIO40, R9 GPIO39, R10 GPIO38, R11 GPIO37, R12 GPIO36, R13 GPIO35, R14 GPIO0, R15 GPIO45, R16 GPIO48, R17 GPIO47, R18 GPIO21, R19 GPIO20, R20 GPIO19, R21 GND, R22 GND.
- The symbol's pin positions are at x=46.99 (L) and x=74.93 (R) when U5 is at (60.96, 27.94). L13 is at (46.99, 58.42) and L14 at (46.99, 60.96).

**GPIO map:**

| Net | GPIO | Net | GPIO |
|---|---|---|---|
| A0 | 1 | D5 | 17 |
| A1 | 2 | D6 | 18 |
| A2 | 4 | D7 | 21 |
| A3 | 5 | D8 (buzzer) | 47 |
| A6 | 6 | D9 | 38 |
| A7 | 7 | D10 | 10 |
| A4/SDA | 8 | D11/COPI | 11 |
| A5/SCL | 9 | D12/CIPO | 13 |
| D0/RX0 | 44 | D13/SCK | 12 |
| D1/TX0 | 43 | D2 | 14 |
| D3 | 15 | D4 | 16 |
| Encoders | 39, 40, 41, 42 | RST | EN |

**Free GPIO:**
- 48, then 45/46/0 and (once VOL_BAT is wired) no longer 3.
- 19/20 are the USB D−/D+.
- 35/36/37 are used by the octal PSRAM.

**VOL_BAT plan:**
- Divider ratio 51/(100+51) = 0.338. A 9 V pack reads about 3.04 V.
- Connect the top of R35 to VCC (the rail after D8/F1), so there is a ~0.4 V diode drop. A pre-diode tap would be more accurate; calibrate in firmware.
- Net name `VOL_BAT`: R35.2, R36.1, C11.1 and U5 L13.
- R36.2 and C11.2 go to GND.
- 1 µF on GPIO3 (JTAG strapping pin; only matters at reset).

**Power:**
- The DevKitC-1 has no VIN, so its 5V pin is fed from +5V (U1, the LM2940, 1 A).
- U1 must always be fitted. USB plus battery back-feed was not verified.
- For 2 servos, a buck 5 V / 3 A is needed.
- The Auriga's V-BAT is battery voltage (check the divider and fuse arrangement before changing it).

**Konnect tool quirks:**
- The tool schema is learned by calling a tool with missing args. Names learned:
  - `add_schematic_component`: `schematic`, `lib_id`, `reference`, `value`, `footprint`, `x`, `y`.
  - `batch_connect_to_net`: top-level `net_name` + `schematic` + `pins:[{reference, pin_number}]`, one net per call.
  - `batch_add_no_connect` / `batch_delete_no_connect`: `positions:[{x,y}]`.
  - `batch_delete`: `uuids`.
  - `add_power_symbol`: `power_net`.
  - `set_schematic_page`: `size`.
  - `edit_schematic_component`: `fields`.
  - `generate_netlist` / `render_schematic_png`: `output`.
  - `get_schematic_pin_locations`: `reference`.
  - `get_symbol_info`: `lib_id`.
  - `search_jlcpcb_parts` needs a database that fails to download (`download_jlcpcb_database` errors); use the public `jlcsearch.tscircuit.com` JSON, e.g. `https://jlcsearch.tscircuit.com/accelerometers/list.json?limit=1000`, via PowerShell `Invoke-RestMethod`.
- Konnect refuses writes when the schematic is open in the KiCad editor (a `~...lck` file); the user must close it.
- Placing a component can also drop labels or junctions where pins touch existing wires, creating unwanted connections. Place in free space.
- `batch_connect_to_net` adds net labels at pin ends. When deleting a component by text edit, also delete its labels and junctions, or ERC reports a dangling label.
- ERC output is saved to a temp JSON file; parse it with Python, filtering on `severity=='error'`.
- Netlist parsing in Python: split on `\n\t\t(net\n`, then `re.findall(r'\(ref "([^"]+)"\)\s*\(pin "([^"]+)"', n)`. Net names appear as `/A4{slash}SDA`.
- Text editing of the .kicad_sch by Python is possible; use `newline=''` and a depth-aware form parser (handle quoted strings). `list_schematic_wires` is not available as a normal tool call.
- kicad-cli is not in PATH.

**Known ERC warnings (pre-existing, ignore):**
- lib_symbol_mismatch (GND, LED, +5V, VCC, R_Potentiometer, Jumper_3_Open, TEPT4400).
- Conn_01x03_Male not found.
- The ARPS library is missing.
- Same-name local/global labels.
- 1 unconnected wire endpoint.

**Unverified:**
- 3.3 V encoder supply.
- Button pull direction (R3–R6 1k).
- The VOL_BAT tap point choice.
</technical_details>

<important_files>
- `D:\_data\projets\_cegep\1sx\ranger_dropin\BEAPER-Nano.kicad_sch`
  - Main schematic, page C.
  - U5 at (60.96,27.94).
  - U6 IMU at about (470,100).
  - M1/M2 at about (380,195) and (380,225).
  - Motor block at the bottom right, around x=227–314, y=183–270.
  - R35/R36/C11 (VOL_BAT parts) at about (440–470, 160), unwired.
- `D:\_data\projets\_cegep\1sx\ranger_dropin\README.md`
  - English documentation of both boards: features, GPIO map, comparison, open items.
  - Needs updating for VOL_BAT.
- `D:\_data\projets\_cegep\1sx\ranger_dropin\ESP32S3.kicad_sym` and `sym-lib-table`
  - The custom DevKitC-1 symbol library (registered as `ESP32S3`).
- `D:\_data\projets\_cegep\1sx\ranger_dropin\BEAPER-Nano.pretty\ESP32-S3-DevKitC-1.kicad_mod`
  - The custom footprint.
- `D:\_data\projets\_cegep\1sx\ranger_dropin\BEAPER-Nano.kicad_pcb`
  - Old PCB, not updated. It is open in KiCad with user changes.
- `D:\_data\projets\_cegep\1sx\ranger_dropin\Me Auriga Schematic.pdf`
  - Auriga reference.
- `C:\Users\nicol\.copilot\session-state\41f4b332-d886-444f-8613-d4b14432f684\files\notes-a-faire.md`
  - Open-items notes (buck converter, LCSC refs, etc.).
- `C:\Users\nicol\.copilot\instructions\basic_instructions.md.instructions.md`
  - Québécois French punctuation rules for French markdown (no space before ? and !; non-breaking space before ":"). Not applied to the English README.
</important_files>

<next_steps>
Immediate:
1. Wire the battery monitor with `batch_connect_to_net`:
   - `VCC`: R35.1.
   - `VOL_BAT`: R35.2, R36.1, C11.1 and U5 L13.
   - `GND`: R36.2, C11.2.
2. Run `generate_netlist` plus a parser. Compare with `after9.net` to confirm no other net changed, and check that `VOL_BAT` has exactly those five pins. Run `run_erc`; target 0 errors, and remove any dangling label with `batch_delete` if reported. Optionally render the PNG to check placement.
3. Add the `LCSC` field to the new parts if possible (C11 1 µF 0402; the 100k/51k 0603 resistors are likely Basic).
4. Update `README.md`:
   - Move battery voltage sensing from "missing" to "present" (GPIO3 / ADC1_CH2, `VOL_BAT`, R35/R36/C11).
   - Update the free-GPIO text (3 is now used).
   - Update the "Missing LCSC references" list.
5. Update `notes-a-faire.md` if useful.
6. Reply to the user in French, concisely: the VOL_BAT divider on GPIO3, with caveats (sensing after D8 has a ~0.4 V offset, GPIO3 is a strapping pin, and ADC calibration is needed).
7. Clean up `%TEMP%\aur.txt`.

Later or pending the user:
- Replace U1 (LM2940) with a 5 V / 3 A buck from JLCPCB (search with jlcsearch).
- Update the PCB once the user gives the board dimensions (`update_pcb_from_schematic`); the DevKitC-1 footprint outline is approximate.
- Optional additions to match the Auriga: a WS2812 RGB ring on GPIO48, a power switch, a microphone, a second light sensor.
- Decide whether to keep CON1 pins 3–6, now redundant with M1/M2.
- Title block comment 3 still says "for Arduino Nano ESP32".
</next_steps>
