nbourre/ranger_dropin/memoire/checkpoints/005-adding-connectors-and-pcb-outl.md

<overview>
The user is converting a KiCad 10 project (BEAPER Nano, a mirobo.tech educational robot board) from through-hole to SMD parts, using JLCPCB/LCSC Basic parts where possible. The board becomes a drop-in carrier for an **ESP32-S3-DevKitC-1-N16R8** that replaces the Makeblock mBot Ranger's Arduino "Auriga" controller. I edit the schematic with the Konnect MCP tools (KiCAD-MCP-Konnect). The user writes in French, so I reply in French and concisely; the README and the pin-map document are in English at the user's request. This segment finished the panel/RGB connector, the RJ25 ports, the Qwiic connectors, and the VL53L1X and OLED headers in the schematic. I was starting the PCB outline and guide holes when the context was compacted.
</overview>

<history>
1. **Earlier segments (see the previous checkpoints).** The Konnect MCP configuration was set up. The schematic was converted to SMD (TB6612FNG replaces the SN754410), battery protection was added, and the DevKitC-1 replaced the Nano ESP32 socket. Motor headers M1/M2, an LSM6DS3TR-C IMU, and VOL_BAT sensing were added. The floor/line sensors, potentiometers and TEPT4400 were removed. I created `README.md` and `AURIGA_PINMAP.md`.

2. **The user gave caliper measurements of the Panel Module.**
   - Module 36.1 × 50 mm. GND headers: 34 mm outside the male plastic, 29.2 mm inside. I inferred 31.75 mm centre to centre.
   - The signal-header offsets (about 42.5 mm and 45.1 mm) were judged correct.
   - I updated `AURIGA_PINMAP.md`.

3. **The user asked: reuse KEY as the general button, and remove the board buttons.**
   - Deleted SW2 to SW5 and R3 to R6. SW1 (reset) was kept.
   - Cleaned dangling wires. ERC was 0 errors.
   - The README was updated (the GPIO table and a TODO entry).

4. **The user asked about GPIO expansion.** I recommended I2C modules (VL53L1X, OLED), no expander for now, and an optional MCP23017. I asked OLED or TFT; no answer came.

5. **Auriga board dimensions and holes.**
   - The user gave the board size: 65.5 × 100 mm, corner radius 2 mm. The original has no mounting holes (it clips in).
   - Three guide holes of Ø 2 mm, confirmed after I read the SVG. Origin top-left, X right, Y down, portrait, ports 1 to 5 on the left and 6 to 10 on the right:
     - GH1 (38.75, 6), 26.75 mm from the right edge, under reset.
     - GH2 (55.5, 83.5), between ports 6 and 7.
     - GH3 (10, 83.5), mirrored, between ports 4 and 5.
   - The new board should also get Makeblock-compatible mounting holes. These are not yet measured (the nominal 8 mm pitch with M4 is only from memory).
   - All of this was documented in `AURIGA_PINMAP.md` and in the README TODO.

6. **The latest request (this segment):**
   1. Add the panel module connector (PRGB).
   2. The VL53L1X and display are off-the-shelf modules. Respect their pinout order and place them logically. The VL53L1X must point in the same direction as the motor connectors would, if placed where they are on the Auriga.
   3. Create the PCB outline and the holes. Placement is later, because parts are still missing.
   - Also: 3 RJ25 connectors (low-power side only, to reuse the Auriga modules) and 2 more Qwiic connectors for expansion.

   Actions taken:
   - My question about the VL53L1X and display model was cancelled twice, so I proceeded with defaults (see technical details).
   - I added the schematic parts and connections below.
   - I then loaded the `pcb_board` toolset. Calls to `get_board_extents` and `delete_graphics` failed with "Argument 'board' is invalid: missing". The parameter is named `board`, not `pcb`.
</history>

<work_done>
Schematic `BEAPER-Nano.kicad_sch` was edited through Konnect. Last ERC: 0 errors, with only old warnings (lib_symbol_mismatch, same-name local/global labels, and some `unconnected_wire_endpoint` warnings). Before the final cleanup there were 25 such warnings; I then deleted 8 leftover GND wires near SW2 to SW5 (x=97.79, y 93.98 to 135.89) and did not re-run ERC after that.

**Components added (placed at y 300 to 410, in a new area below the existing circuit):**
- J5, J6, J7: `Connector:RJ25` (6P6C), footprint `Connector_RJ:RJ12_Amphenol_54601-x06_Horizontal`. Values "RJ25 port A/B/C", at x=60/120/180, y=310.
  - Pins: 1 = SCL (net `A5/SCL`), 2 = SDA (net `A4/SDA`), 3 = GND, 4 = +5V, 5 = S1, 6 = S2.
  - Port A: S1 = `PA_S1` (GPIO1, U5.R4), S2 = `PA_S2` (GPIO15, U5.L8).
  - Port B: S1 = `PB_S1` (GPIO43, U5.R2), S2 = `PB_S2` (GPIO44, U5.R3).
  - Port C: S1 = `D9` (GPIO38), S2 = `D10` (GPIO10). These nets are shared with the SPI header J3.
- J8, J9: `Conn_01x04`, Qwiic JST SH 4-pin (footprint `JST_SH_SM04B-SRSS-TB`), at y=360. Pins: 1 GND, 2 +3V3, 3 SDA, 4 SCL (same as the existing J4).
- J10: `Conn_01x06` socket, "VL53L1X module", assumed Pololu order: 1 VIN (+3V3), 2 GND, 3 SDA, 4 SCL, 5 XSHUT (no-connect), 6 GPIO1/INT (no-connect). Footprint `PinSocket_1x06`.
- J11: `Conn_01x04` socket, "OLED I2C", assumed order: 1 GND, 2 +3V3, 3 SCL, 4 SDA.
- J12: `Conn_01x07` socket, "PRGB (Auriga panel module)", left to right:

  | Pin | Net |
  |---|---|
  | 1 | `VCC` (V-BAT) |
  | 2 | `KEY` |
  | 3 | `A2` (LIGHT2, GPIO4) |
  | 4 | `A3` (LIGHT1, GPIO5) |
  | 5 | `RGB` |
  | 6 | GND |
  | 7 | +5V |

- J13, J14: `Conn_01x02`, "PG1/PG2 (GND support)", with both pins on GND.
- U7: `74xGxx:74AHCT1G125` (SOT-23-5), used as a 3.3 V → 5 V level shifter for the LED data line.
  - Pin 1 (OE) = GND, pin 2 (A) = `RGB_3V3` (GPIO48, U5.R16), pin 3 = GND, pin 4 (Y) = `RGB_BUF`, pin 5 = +5V.
  - C12 (100 nF) sits across +5V/GND.
- R39 (220 Ω) joins `RGB_BUF` to `RGB`.
- KEY chain: J12.2 (`KEY`) → R38 (1k) → `KEY_GPIO` (GPIO14, U5.L20), with R37 (10k) pull-up to +3V3 on `KEY_GPIO`.

**Components and labels removed:**
- Old D0/D1/D2/D3 labels at the U5 pins and the orphan labels/wires of the deleted buttons. The no-connects on U5 L4, L5, R4 and R16 were deleted too.

Netlist `after15.net` in the session `files\` is from before these changes. `README.md` and `AURIGA_PINMAP.md` were updated up to the guide-hole table. **The README GPIO table and TODO have not yet been updated for the new connectors.**

**Not yet done:**
- PCB: no outline, no holes. KiCad has the PCB open with user changes.
- README/PINMAP: add the new GPIO allocation, the connectors, the assumptions, and the level-shifter note.
- Re-run ERC after the last wire deletions.
- Delete the temp files in `%TEMP%` (`full.png` was already deleted).
</work_done>

<technical_details>
**GPIO allocation after this segment (free GPIOs were 1, 4, 5, 14, 15, 43, 44, 48):**

| GPIO | Net / use |
|---|---|
| 1 | `PA_S1` |
| 4 | `A2` (LIGHT2) |
| 5 | `A3` (LIGHT1) |
| 14 | `KEY_GPIO` |
| 15 | `PA_S2` |
| 43 | `PB_S1` |
| 44 | `PB_S2` |
| 48 | `RGB_3V3` (also the on-board RGB LED) |
| 38 | D9 (J3 and RJ25 C) |
| 10 | D10 (J3 and RJ25 C) |

- Other GPIOs are unchanged: A1=2, SDA/A4=8, SCL/A5=9, A6=6, A7=7, D4 to D7 = 16, 17, 18, 21, D8 buzzer=47, D11/12/13 = 11/13/12, encoders = 39 to 42, VOL_BAT=3.
- Strapping pins 0, 45 and 46 are left unused. GPIO 43/44 are the UART0 pins used by the DevKitC-1's USB-UART bridge, so a module driving them could conflict while the UART USB is connected. Port C shares D9/D10 with the SPI header J3.
- U2 (74HCT541) has all 8 channels used (D4 to D7 LEDs and A4 to A7 sonar/servo), so the LED data line needed its own shifter (U7).
- I2C bus nets: `A4/SDA` and `A5/SCL`. The 4k7 pull-ups R16/R17 are to +3V3. The RJ25 I2C pins are 3.3 V logic here (5 V on the Auriga). A module with 5 V pull-ups could be a problem; this is flagged.
- KEY: its role on the Auriga module is not confirmed (it was the POWER button into the power-latch circuit). I assumed an active-low button. A series resistor and a pull-up are used. Whether the module still ties it to V-BAT or to GND needs checking.
- The V-BAT pin on J12 is connected to the net `VCC` (protected battery, after F1/D8).
- VL53L1X and OLED pin orders are assumed (the user cancelled my question about the models twice). The VL53L1X orientation must match the motor-connector side on the Auriga placement.
- LCSC refs were not found: the jlcsearch search is poor for connectors and for the 74AHCT1G125. LCSC numbers are still a to-do.
- Net labels: both "A5/SCL" and "A5{slash}SCL" forms resolve to the same net `/A5{slash}SCL` in the netlist.
- Net names created: `KEY`, `KEY_GPIO`, `A2`, `A3`, `RGB_3V3`, `RGB_BUF`, `RGB`, `PA_S1`, `PA_S2`, `PB_S1`, `PB_S2`.
- Konnect quirks:
  - Several parallel calls are fine. The schema is learned by calling with missing arguments.
  - `batch_connect_to_net` takes top-level `net_name`, `schematic` and `pins:[{reference, pin_number}]`, and puts labels at the pin ends.
  - `delete_schematic_net_label` takes `net`, `schematic`, `x`, `y`. `batch_delete` takes `uuids`. `batch_add_no_connect` and `batch_delete_no_connect` take `positions`.
  - `generate_netlist` takes `output`. Schematic writes worked even with the file open in KiCad.
  - ERC output is saved to a temp JSON file; parse it with PowerShell `ConvertFrom-Json`.
  - After deleting components, dangling wires and labels remain and must be cleaned manually.
  - Netlist parsing: split `$n` on `\r?\n\t\t\(net\r?\n` and use the regex `\(ref "([^"]+)"\)\s*\(pin "([^"]+)"`.
  - The PCB tools (`pcb_board`: `delete_graphics`, `add_board_outline`, `set_board_size`, `add_mounting_hole`, `get_board_extents`) take the parameter **`board`** (not `pcb`) for the .kicad_pcb path.
  - `add_board_outline` supports circular rounded corners. It appends, so `delete_graphics(layer='Edge.Cuts')` must be run first if an outline already exists. `add_mounting_hole` only accepts drills that KiCad ships a MountingHole footprint for (3.2 → M3, 3 → 3 mm). A Ø 2 mm hole may not be supported (a custom footprint or another method may be needed).
  - ImageMagick cannot render the SVG; `fitz` (PyMuPDF) can. The KiCad install is at `C:\Users\nicol\AppData\Local\Programs\KiCad\10.0\` (share at `share\kicad`, `kicad-cli.exe` in `bin`).
- A PowerShell command run in a sync shell sometimes gets "moved to background by the user"; results are then read with `read_powershell`.
- Libraries found: symbol `Connector:RJ25` and `6P6C`, `74xGxx:74AHCT1G125`, footprint `Connector_RJ:RJ12_Amphenol_54601-x06_Horizontal`, `Package_TO_SOT_SMD:SOT-23-5`, `Connector_PinSocket_2.54mm:PinSocket_1x0{2,4,6,7}_P2.54mm_Vertical`.
</technical_details>

<important_files>
- `D:\_data\projets\_cegep\1sx\ranger_dropin\BEAPER-Nano.kicad_sch`
  - Main schematic (page C). This segment added J5 to J14, U7, C12 and R37 to R39. Buttons SW2 to SW5 and R3 to R6 were removed.
  - Last ERC: 0 errors.
- `D:\_data\projets\_cegep\1sx\ranger_dropin\BEAPER-Nano.kicad_pcb`
  - Old PCB, not updated. Open in KiCad with user changes. Needs the 65.5 × 100 mm outline (2 mm corners), the guide holes, and `update_pcb_from_schematic` (placement is later).
- `D:\_data\projets\_cegep\1sx\ranger_dropin\README.md`
  - English documentation, with sections 1 to 5, including TODO. It still needs: the new GPIO allocation, the connectors J5 to J14, the KEY/RGB/level-shifter design, and the assumed VL53L1X/OLED pin orders. The TODO lists remaining items (guide holes, mounting holes, the RGB/light module, and so on).
- `D:\_data\projets\_cegep\1sx\ranger_dropin\AURIGA_PINMAP.md`
  - The Auriga pin map. It includes the board size, the guide-hole table (origin top-left), and the Panel Module geometry (36.1 × 50 mm, GND headers 31.75 mm apart, signal offsets about 42.5/45.1 mm).
- `D:\_data\projets\_cegep\1sx\ranger_dropin\auriga\Me Auriga Schematic.pdf` and `auriga\Pinout-Auriga.svg`
  - Source documents.
- `ESP32S3.kicad_sym`, `sym-lib-table`, `BEAPER-Nano.pretty\ESP32-S3-DevKitC-1.kicad_mod`
  - Custom DevKitC-1 library.
- `C:\Users\nicol\.copilot\session-state\41f4b332-d886-444f-8613-d4b14432f684\files\` (`notes-a-faire.md`, `after*.net`)
  - Notes and netlist snapshots.
</important_files>

<next_steps>
Immediate:
1. PCB: retry with the `board` parameter set to `D:\_data\projets\_cegep\1sx\ranger_dropin\BEAPER-Nano.kicad_pcb`.
   - Run `get_board_extents`, then `delete_graphics` with `dry_run` on Edge.Cuts to see the old outline.
   - Delete the old outline, then `add_board_outline` (65.5 × 100 mm, 2 mm corner radius, portrait orientation).
   - Add the 3 guide holes (Ø 2 mm), at coordinates relative to the board origin: (38.75, 6), (55.5, 83.5), (10, 83.5).
   - Check whether `add_mounting_hole` accepts 2 mm; if not, use another approach (a custom footprint or an NPTH pad).
   - The user's PCB is open in KiCad, so beware of conflicts with unsaved changes.
2. Re-run ERC after the last wire deletions.
3. Update `README.md`:
   - The GPIO table.
   - The new connectors.
   - The assumptions (VL53L1X Pololu pinout, OLED order, KEY polarity).
   - The TODO (check off the RGB/light module, the VL53L1X and the Qwiic items; add the guide holes status).
4. Update `AURIGA_PINMAP.md` section 4 (the Auriga → ESP32-S3 mapping) for the new GPIO assignments.
5. Report to the user in French, concisely:
   - The GPIO allocation, and the sharing of port C with J3 (D9/D10).
   - The 43/44 UART caveat.
   - The assumed module pin orders, to be confirmed.
   - The unanswered questions: which VL53L1X and OLED modules; the placement orientation of the VL53L1X (same direction as the motor connectors); the KEY polarity and whether it is tied to V-BAT on the module.

Later or pending the user:
- Makeblock mounting holes (measure on a real beam; nominal 8 mm pitch, M4).
- Component placement on the PCB (the user said parts are still missing). Use `update_pcb_from_schematic` afterwards. The 3 RJ25 and the Qwiic connectors should be on the board edge, and the panel header geometry must be reproduced (1×7 plus the two 1×2 GND headers).
- LCSC refs (F1, D8, D9, C8, R31 to R39, C9 to C12, M1/M2, U7, the RJ25 and Qwiic connectors).
- A 5 V / 3 A buck to replace U1 (LM2940) for servos.
- Fix the title block comment 3 ("for Arduino Nano ESP32").
- Decide whether to keep CON1 pins 3 to 6 (redundant with M1/M2).
- Optionally add an expander (MCP23017) if more GPIOs are needed.
- Delete the temp files.
</next_steps>
