nbourre/ranger_dropin/memoire/checkpoints/index.md

# Checkpoint History

Checkpoints are listed in chronological order. Checkpoint 1 is the oldest, higher numbers are more recent.

| # | Title | File |
|---|---|---|
| 1 | Auriga motor power comparison | 001-auriga-motor-power-comparison.md |
| 2 | Swapping Nano socket for ESP32-S3 | 002-swapping-nano-socket-for-esp32.md |
| 3 | Adding battery voltage monitor | 003-adding-battery-voltage-monitor.md |
| 4 | Auriga pin map and panel module | 004-auriga-pin-map-and-panel-modul.md |
| 5 | Adding connectors and PCB outline | 005-adding-connectors-and-pcb-outl.md |
