nbourre/ranger_dropin/auriga/photos/PXL_20261021_132914617 (Custom).jpg

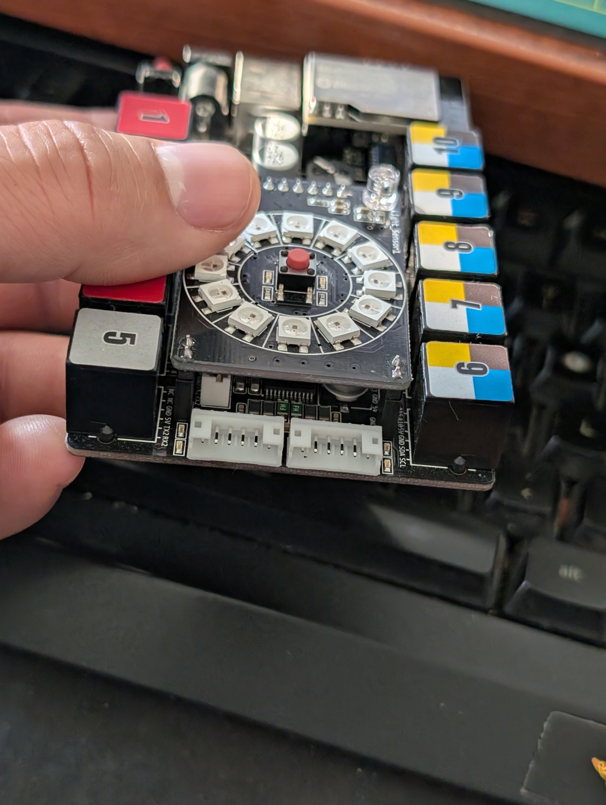
auriga/photos/PXL_20261021_132914617 (Custom).jpg
