nbourre/ranger_dropin/auriga/photos/PXL_20261021_132922015 (Custom).jpg

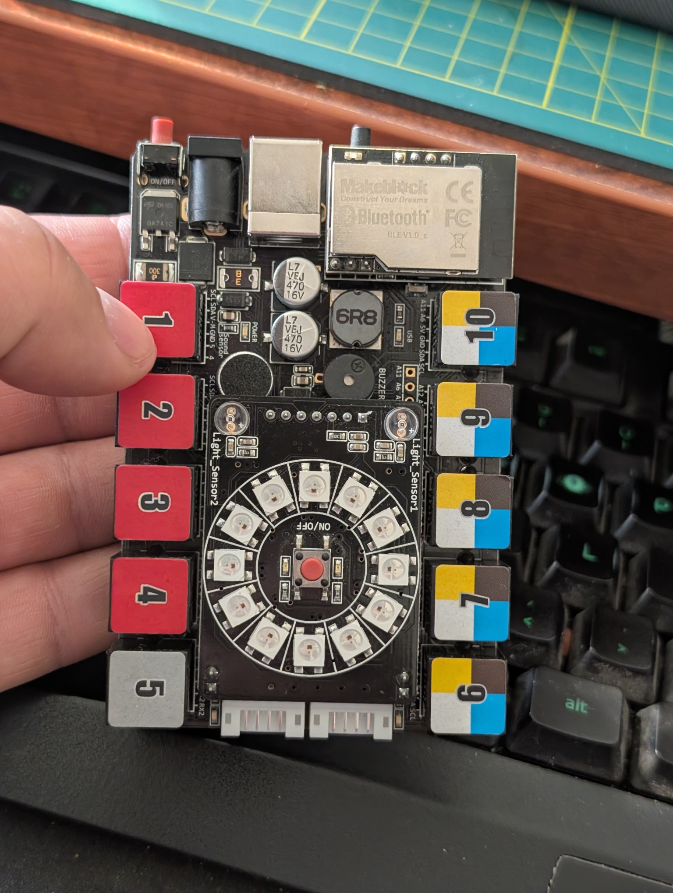
auriga/photos/PXL_20261021_132922015 (Custom).jpg
