nbourre/ranger_dropin/auriga/photos/PXL_20261021_132939538 (Custom).jpg

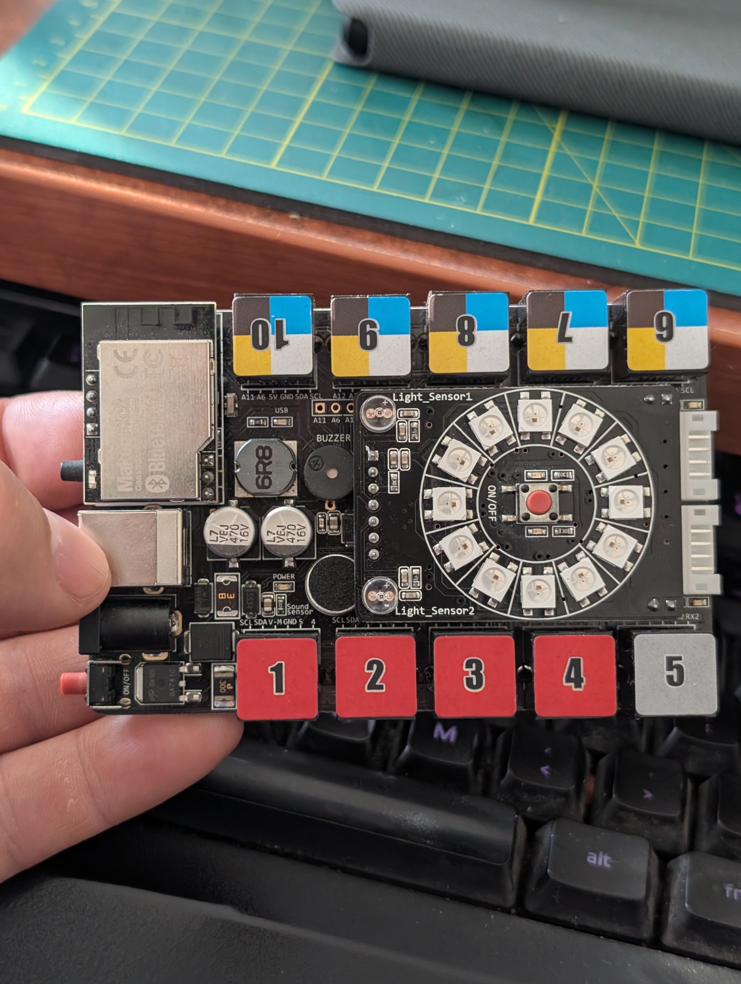
auriga/photos/PXL_20261021_132939538 (Custom).jpg
