nbourre/ranger_dropin/auriga/photos/PXL_20261021_132954236 (Custom).jpg

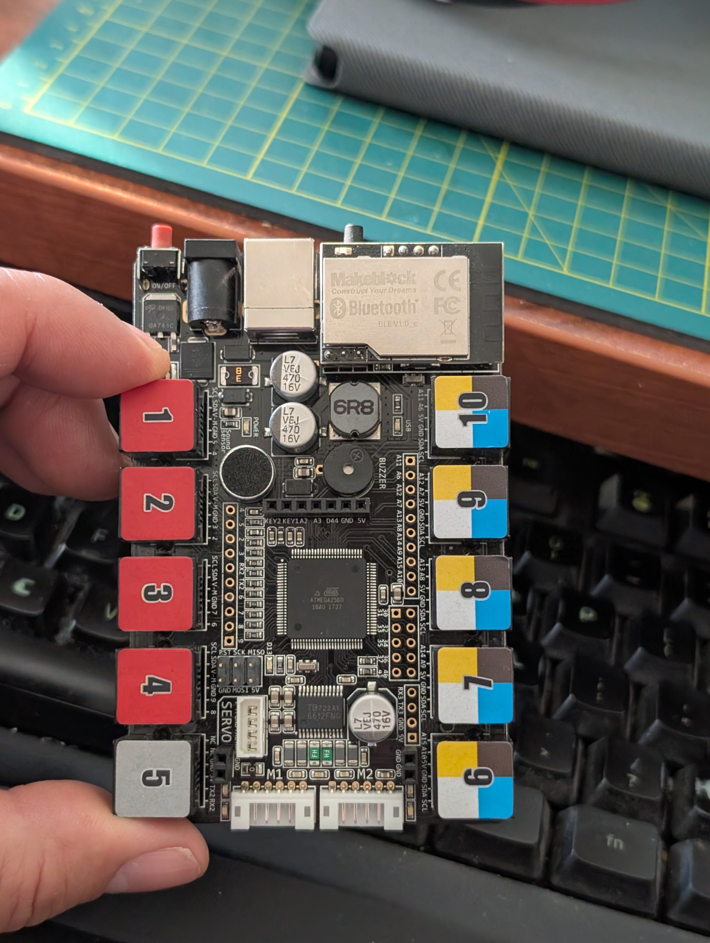
auriga/photos/PXL_20261021_132954236 (Custom).jpg
