nbourre/ranger_dropin/BEAPER Nano Parts.xlsx

Index | Qty. | Manufacturer Part Number | Manufacturer Name | Description | Digi-Key Part Number 1 | Datasheet
1 | 4 | ESS106M050AE2AA | KEMET | CAP ALUM 10UF 20% 50V RADIAL | 399-ESS106M050AE2AA-ND | https://connect.kemet.com:7667/gateway/IntelliData-ComponentDocumentation/1.0/download/datasheet/ESS106M050AE2AA
2 | 3 | C320C104K5R5TA | KEMET | CAP CER 0.1UF 50V X7R RADIAL | 399-4264-ND | https://connect.kemet.com:7667/gateway/IntelliData-ComponentDocumentation/1.0/download/datasheet/C322C102K1R5TA.pdf
3 | 1 | 1729160 | Phoenix Contact | TERM BLK 6P SIDE ENT 5.08MM PCB | 277-1251-ND | https://www.phoenixcontact.com/us/products/1729160/pdf
4 | 2 | PRPC040SAAN-RC | Sullins Connector Solutions | CONN HEADER VERT 40POS 2.54MM | S1011EC-40-ND | https://mm.digikey.com/Volume0/opasdata/d220001/medias/docus/386/xRxCzzzSxxN-RC_ST_11635-B.pdf
5 | 4 | NPC02SXON-RC | Sullins Connector Solutions | CONN JUMPER SHORTING .100" GOLD | S9341-ND | https://s3.amazonaws.com/catalogspreads-pdf/PAGE128-129%20.100%20JUMPER.pdf
6 | 1 | PPTC041LFBN-RC | Sullins Connector Solutions | CONN HDR 4POS 0.1 TIN PCB | S7002-ND | https://mm.digikey.com/Volume0/opasdata/d220001/medias/docus/937/Female_Headers.100_DS.pdf
7 | 2 | PPPC151LFBN-RC | Sullins Connector Solutions | CONN HDR 15POS 0.1 GOLD PCB | S7048-ND | https://mm.digikey.com/Volume0/opasdata/d220001/medias/docus/937/Female_Headers.100_DS.pdf
8 | 1 | PPPC081LFBN-RC | Sullins Connector Solutions | CONN HDR 8POS 0.1 GOLD PCB | S7041-ND | https://mm.digikey.com/Volume0/opasdata/d220001/medias/docus/937/Female_Headers.100_DS.pdf
9 | 1 | SM04B-SRSS-TB | JST Sales America Inc. | CONN HEADER SMD R/A 4POS 1MM | 455-SM04B-SRSS-TBCT-ND | https://www.jst-mfg.com/product/pdf/eng/eSH.pdf
10 | 5 | LTL-4251N | Lite-On Inc. | LED YELLOW DIFFUSED T-1 T/H | 160-1145-ND | https://mm.digikey.com/Volume0/opasdata/d220001/medias/docus/927/LTL-4251N.pdf
11 | 2 | OED-EL-1L2 | Lumex Opto/Components Inc. | EMITTER IR 940NM 100MA RADIAL | 67-1001-ND | https://www.lumex.com/spec/OED-EL-1L2.pdf
12 | 3 | LTR-4206E | Lite-On Inc. | SENSOR PHOTO 940NM TOP VIEW T1 | 160-1030-ND | https://optoelectronics.liteon.com/upload/download/DS-50-92-0073/R4206E.pdf
13 | 1 | TEPT4400 | Vishay Semiconductor Opto Division | SENSOR PHOTO 570NM TOP VIEW RAD | 751-1057-ND | https://www.vishay.com/docs/81341/tept4400.pdf
14 | 11 | CFR-25JB-52-100R | YAGEO | RES 100 OHM 5% 1/4W AXIAL | 100QBK-ND | https://www.yageo.com/upload/media/product/app/datasheet/lr/yageo-cfr_datasheet.pdf
15 | 4 | CFR-25JB-52-270R | YAGEO | RES 270 OHM 5% 1/4W AXIAL | 270QBK-ND | https://www.yageo.com/upload/media/product/app/datasheet/lr/yageo-cfr_datasheet.pdf
16 | 6 | CFR-25JB-52-1K | YAGEO | RES 1K OHM 5% 1/4W AXIAL | 1.0KQBK-ND | https://www.yageo.com/upload/media/product/app/datasheet/lr/yageo-cfr_datasheet.pdf
17 | 6 | CFR-25JB-52-4K7 | YAGEO | RES 4.7K OHM 5% 1/4W AXIAL | 13-CFR-25JB-52-4K7-ND | https://www.yageo.com/upload/media/product/app/datasheet/lr/yageo-cfr_datasheet.pdf
18 | 1 | CFR-25JB-52-10K | YAGEO | RES 10K OHM 5% 1/4W AXIAL | 13-CFR-25JB-52-10K-ND | https://www.yageo.com/upload/media/product/app/datasheet/lr/yageo-cfr_datasheet.pdf
19 | 1 | MFR-25FBF52-5K62 | YAGEO | RES 5.62K OHM 1% 1/4W AXIAL | 5.62KXBK-ND | https://www.yageo.com/upload/media/product/app/datasheet/lr/yageo-mfr_datasheet.pdf
20 | 1 | MFR-25FBF52-1K37 | YAGEO | RES 1.37K OHM 1% 1/4W AXIAL | 1.37KXBK-ND | https://www.yageo.com/upload/media/product/app/datasheet/lr/yageo-mfr_datasheet.pdf
21 | 2 | PTV09A-4220U-B103 | Bourns Inc. | POT 10K OHM 1/20W CARBON LINEAR | PTV09A-4220U-B103-ND | https://www.bourns.com/docs/Product-Datasheets/PTV09.pdf
22 | 5 | B3F-1000 | Omron Electronics Inc-EMC Div | SWITCH TACTILE SPST-NO 0.05A 24V | SW400-ND | https://omronfs.omron.com/en_US/ecb/products/pdf/en-b3f.pdf
23 | 1 | PS1240P02BT | TDK Corporation | BUZZER PIEZO 3V 12.2MM TH | 445-2525-1-ND | https://product.tdk.com/en/system/files
24 | 1 | LM2940T-5.0/NOPB | Texas Instruments | IC REG LINEAR 5V 1A TO220-3 | LM2940T-5.0/NOPB-ND | https://www.ti.com/general/docs/suppproductinfo.tsp?distId=10
25 | 1 | CD74HCT541E | Texas Instruments | IC BUF NON-INVERT 5.5V 20DIP | 296-2127-5-ND | https://www.ti.com/general/docs/suppproductinfo.tsp?distId=10
26 | 1 | 245-20-1-03 | CNC Tech | CONN IC DIP SOCKET 20POS TIN | 1175-2553-ND | https://www.cnctech.us/pdfs/245-XX-1-03.pdf
27 | 1 | SN754410NE | Texas Instruments | IC HALF-H DRIVER 5.5V 16DIP | 296-9911-5-ND | https://www.ti.com/general/docs/suppproductinfo.tsp?distId=10
28 | 1 | A 16-LC-TT | Assmann WSW Components | CONN IC DIP SOCKET 16POS TIN | AE9992-ND | http://www.assmann-wsw.com/uploads/datasheets/ASS_0810_CO.pdf
29 | 1 | MCP9700A-E/TO | Microchip Technology | SENSOR ANALOG -40C-125C TO92-3 | MCP9700A-E/TO-ND | https://ww1.microchip.com/downloads/aemDocuments/documents/MSLD/ProductDocuments/DataSheets/MCP970X-Family-Data-Sheet-DS20001942.pdf
30 | 1 | 3942 | Adafruit Industries LLC | ULTRASONIC SENSOR SONAR DISTANCE | 1528-2711-ND | https://mm.digikey.com/Volume0/opasdata/d220001/medias/docus/692/3942_Web.pdf
31 | 1 | 13615 | Desco | BAG STATIC SHIELD METAL IN 4"X6" | 16-1033-ND | https://www.descoindustries.com/PDF/13605.pdf
