nbourre/ranger_dropin/PDF/BEAPER-Nano.pdf

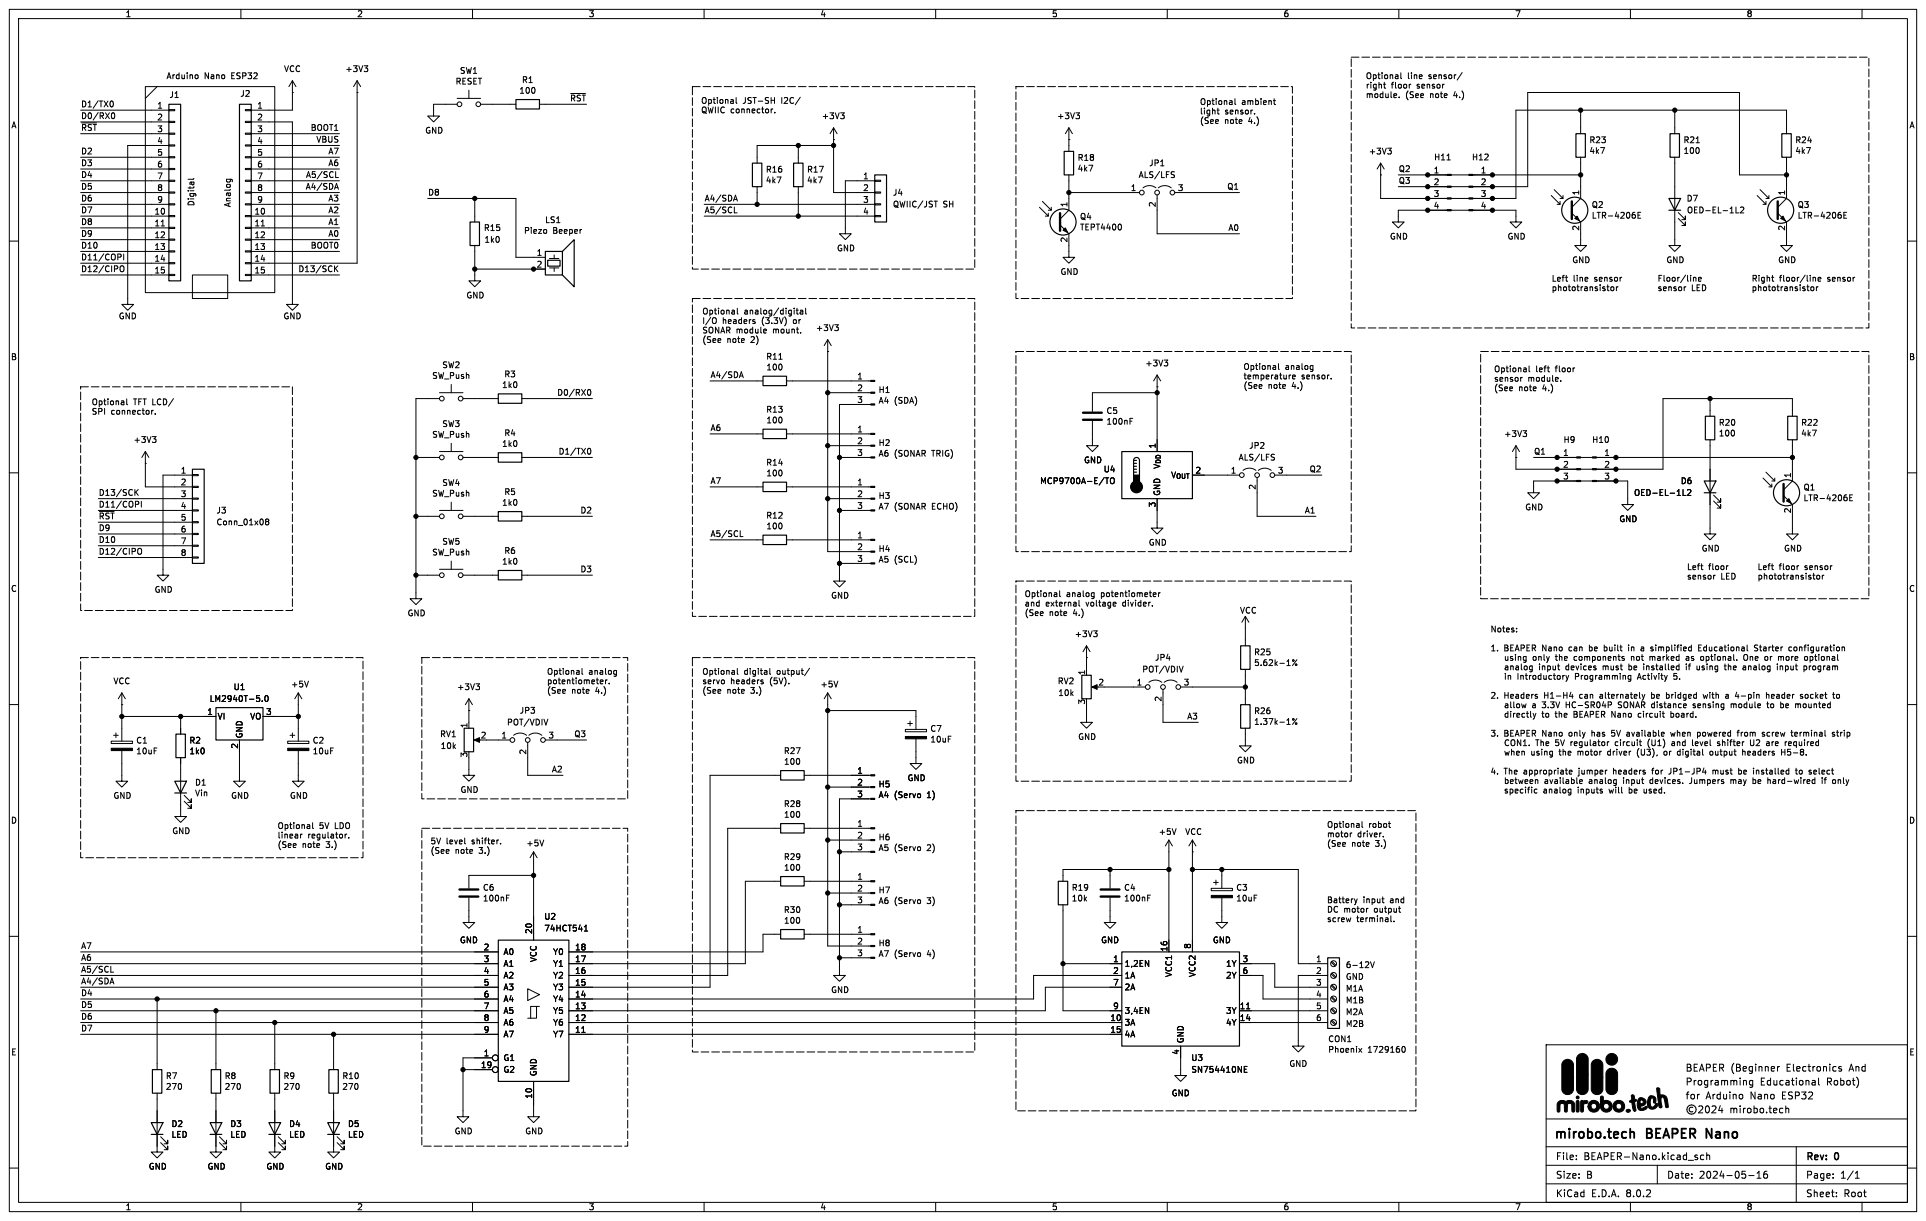
[picture p7: page 1]

light sensor. (See note 4.)

GND
Left line sensor phototransistor

Left floor sensor phototransistor
