nbourre/ranger_dropin/PDF/BEAPER-Nano-B_Cu.pdf

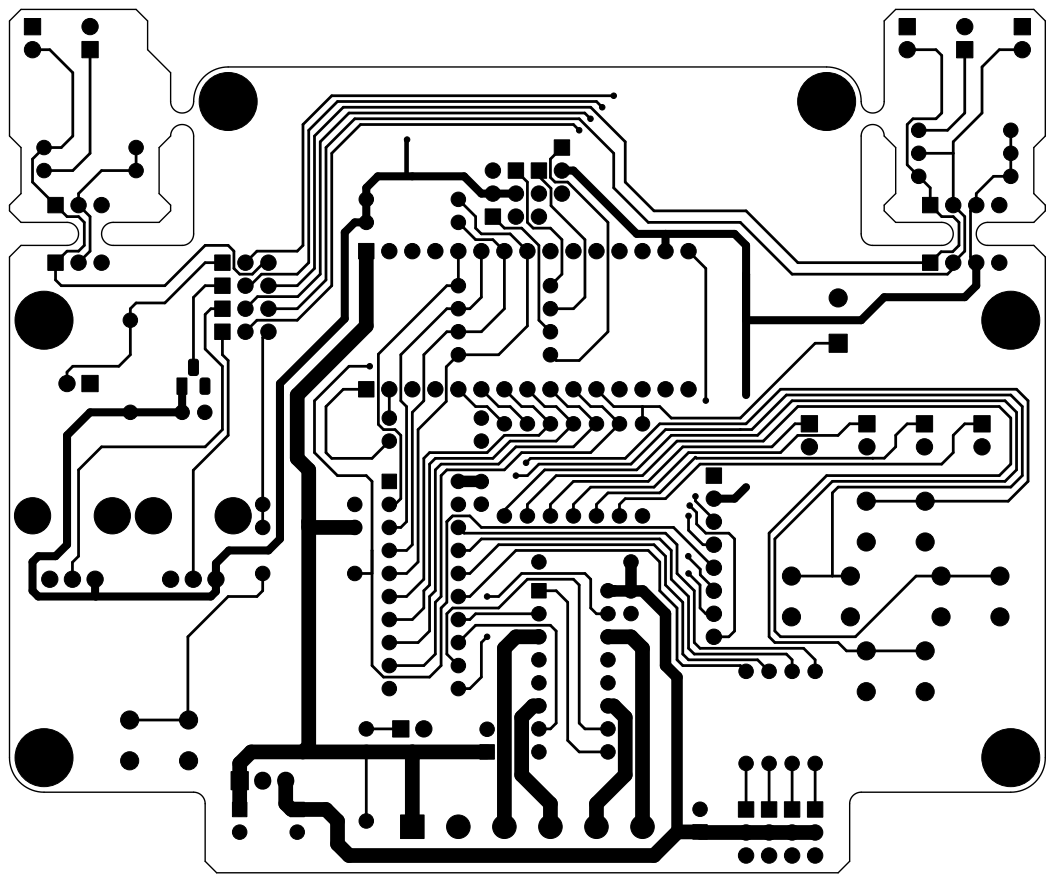
[picture p8: page 1]
