nbourre/ranger_dropin/PDF/BEAPER-Nano-B_Mask.pdf

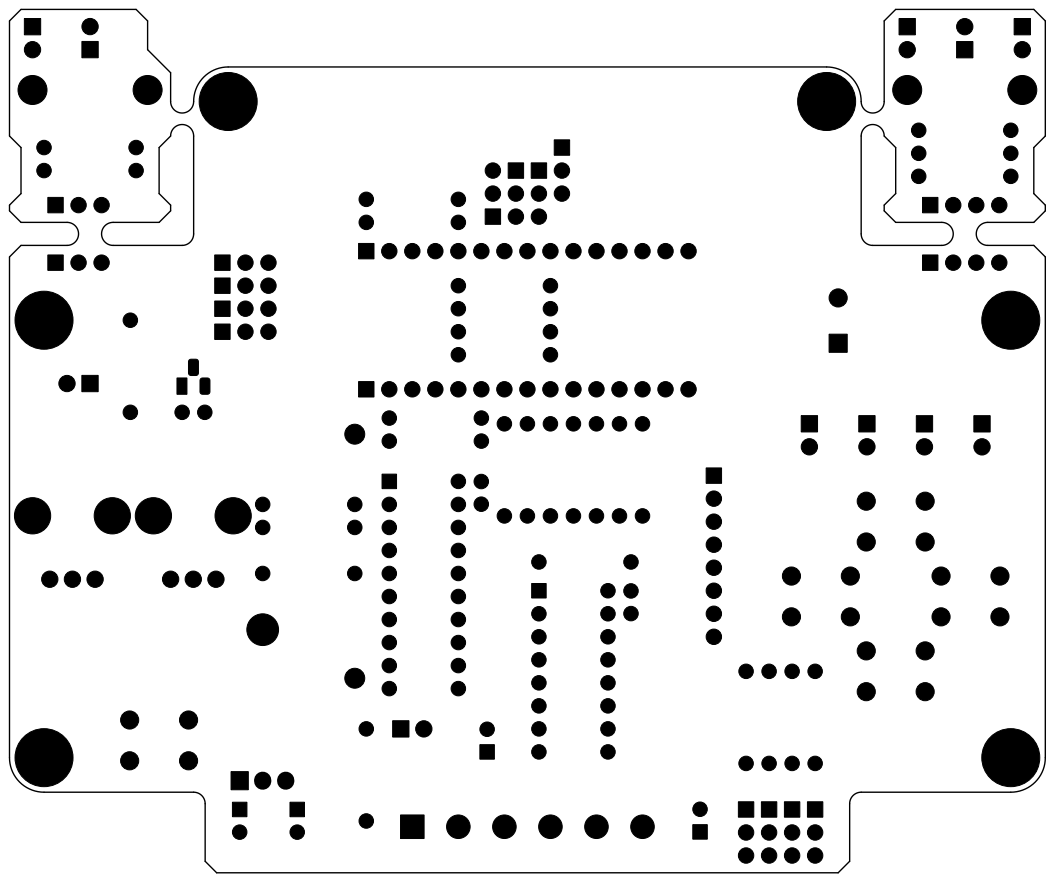
[picture p9: page 1]
