nbourre/ranger_dropin/PDF/BEAPER-Nano-B_Silkscreen.pdf

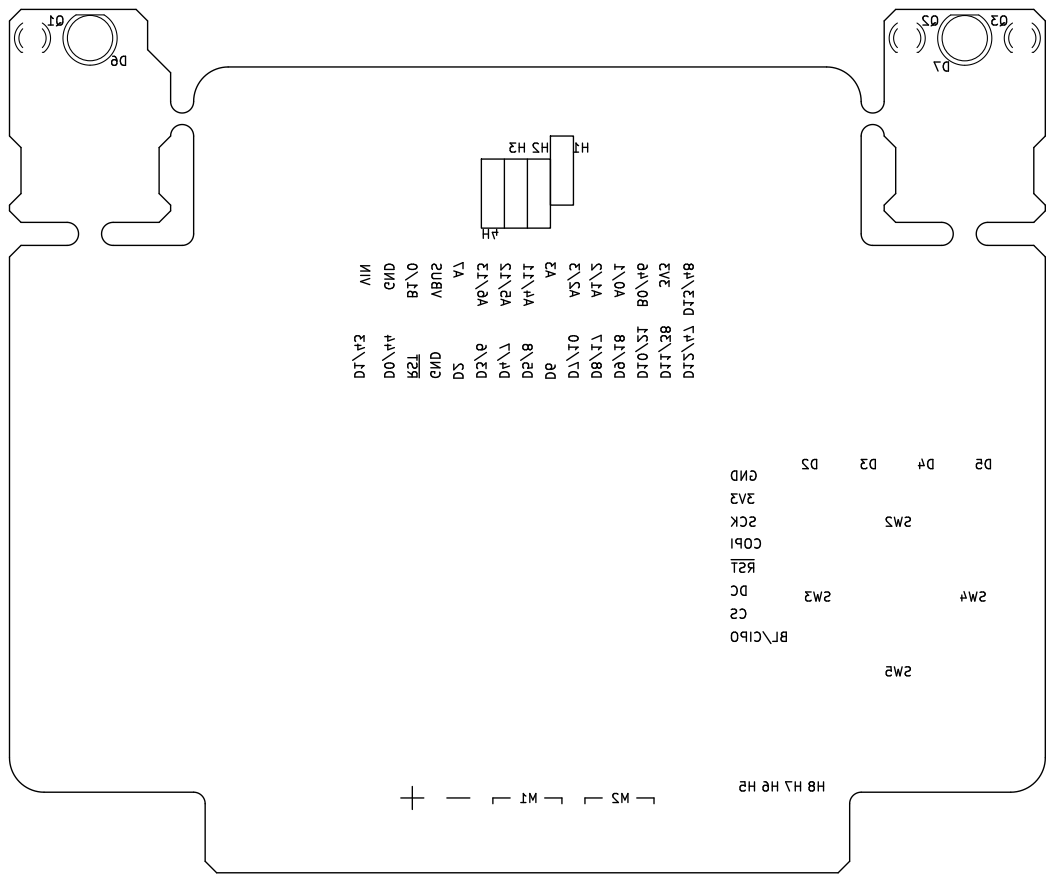
[picture p10: page 1]

H2 SW5 SCK H7 DC A2/3 D6 A1/2A7 H4 3V3 VBUS D4/7 VIN

D3 RST D0/44 D2D7/10 A6/13 B1/0 D12/47 A4/11 SW3 D10/21 COPI A3 BL/CIPO D9/18
