nbourre/ranger_dropin/PDF/BEAPER-Nano-Edge_Cuts.pdf

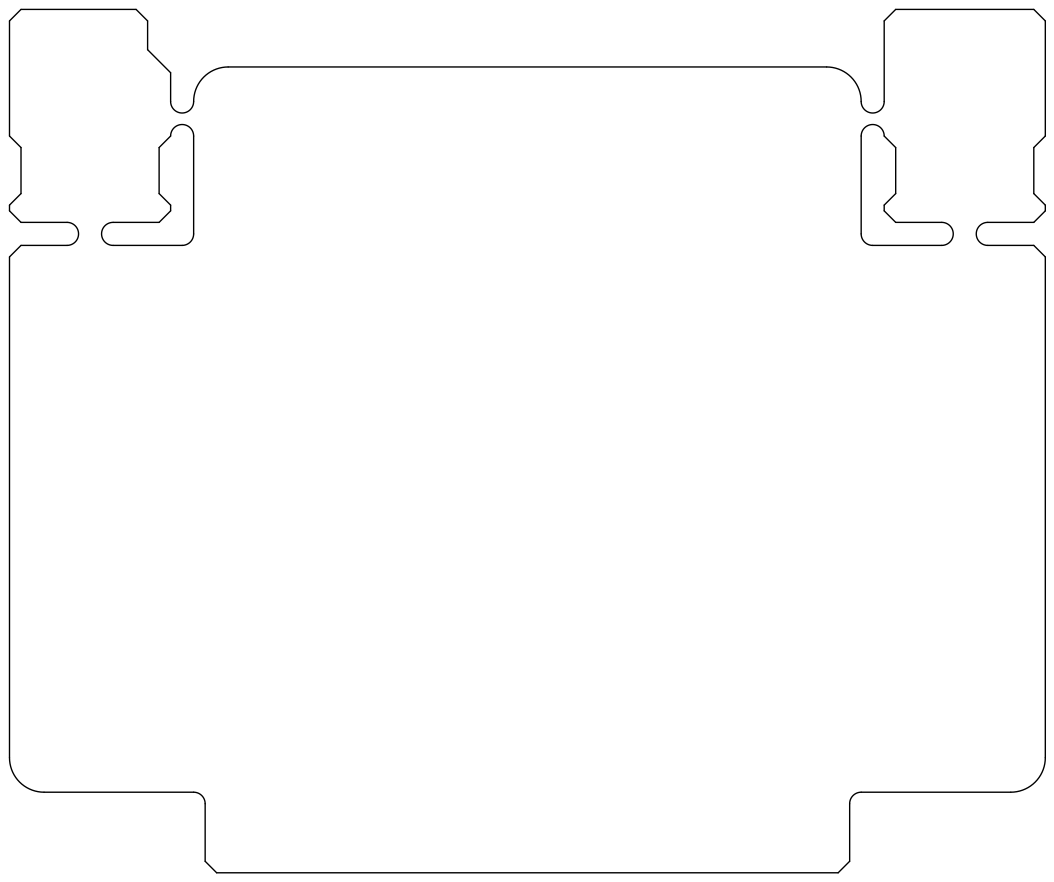
[picture p11: page 1]
