nbourre/ranger_dropin/PDF/BEAPER-Nano-F_Cu.pdf

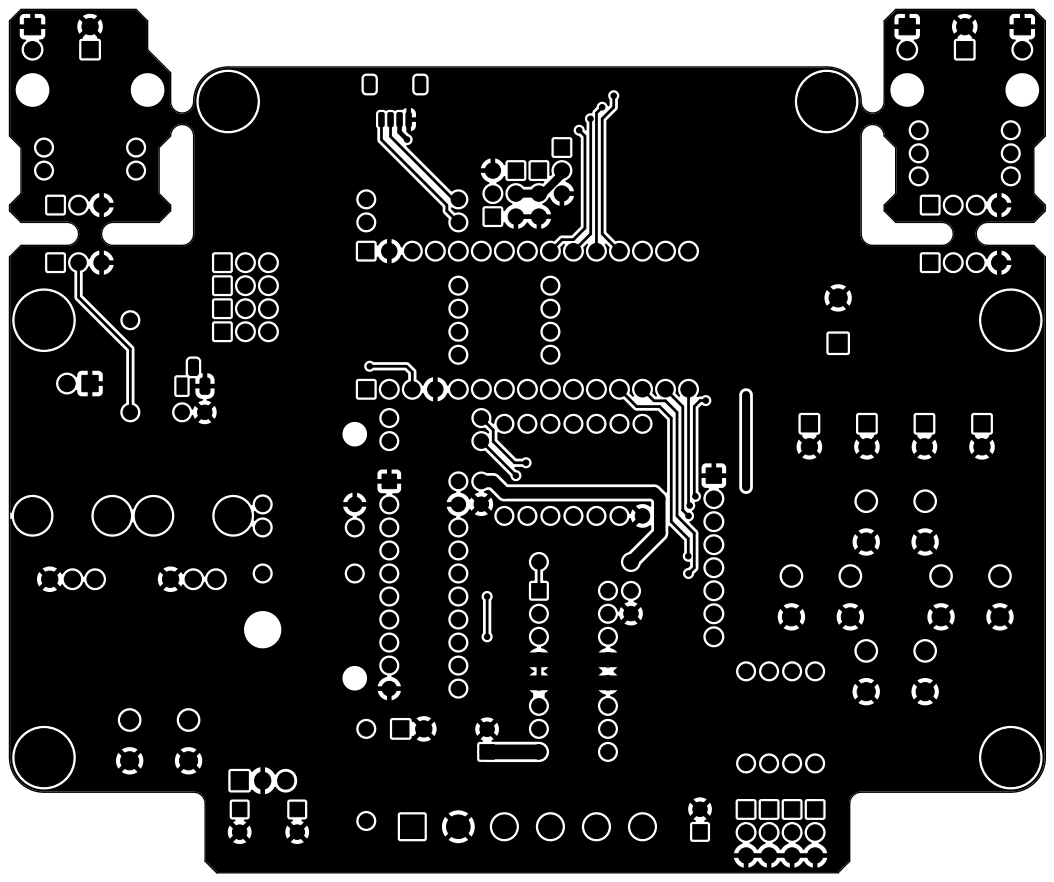
[picture p12: page 1]
