nbourre/ranger_dropin/PDF/BEAPER-Nano-F_Mask.pdf

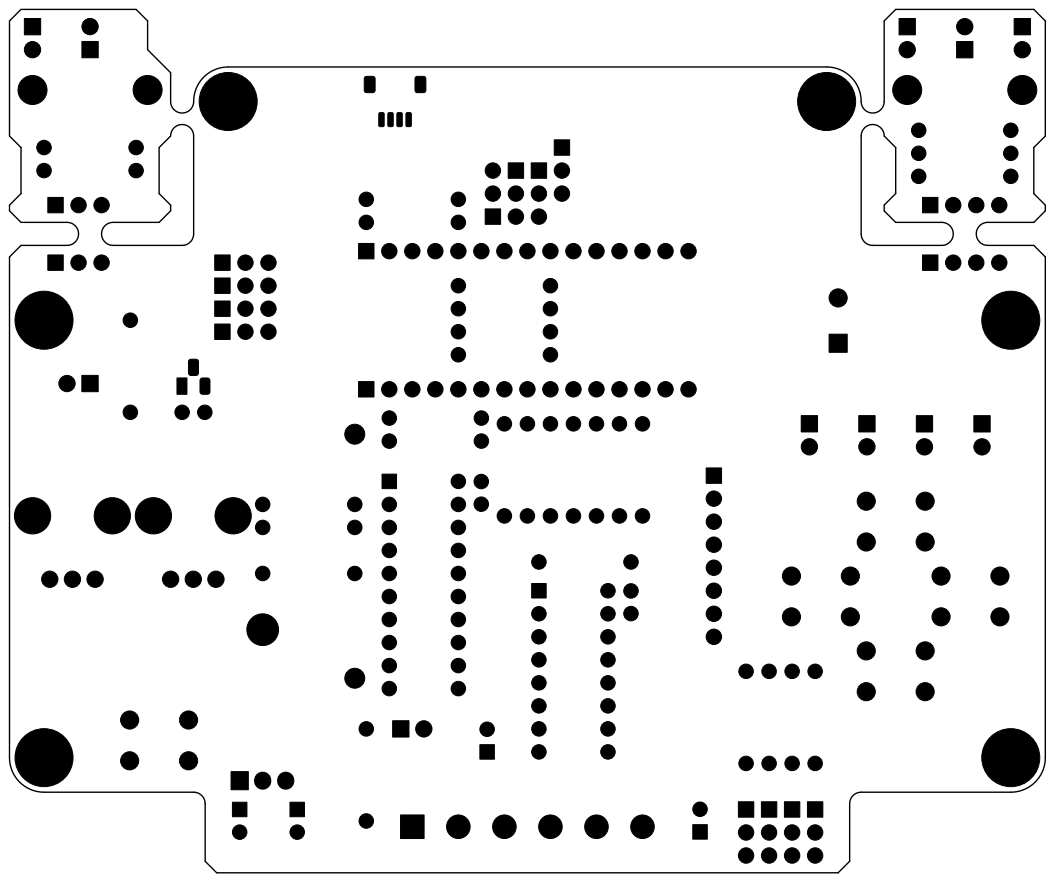
[picture p13: page 1]
