nbourre/ranger_dropin/PDF/BEAPER-Nano-F_Silkscreen.pdf

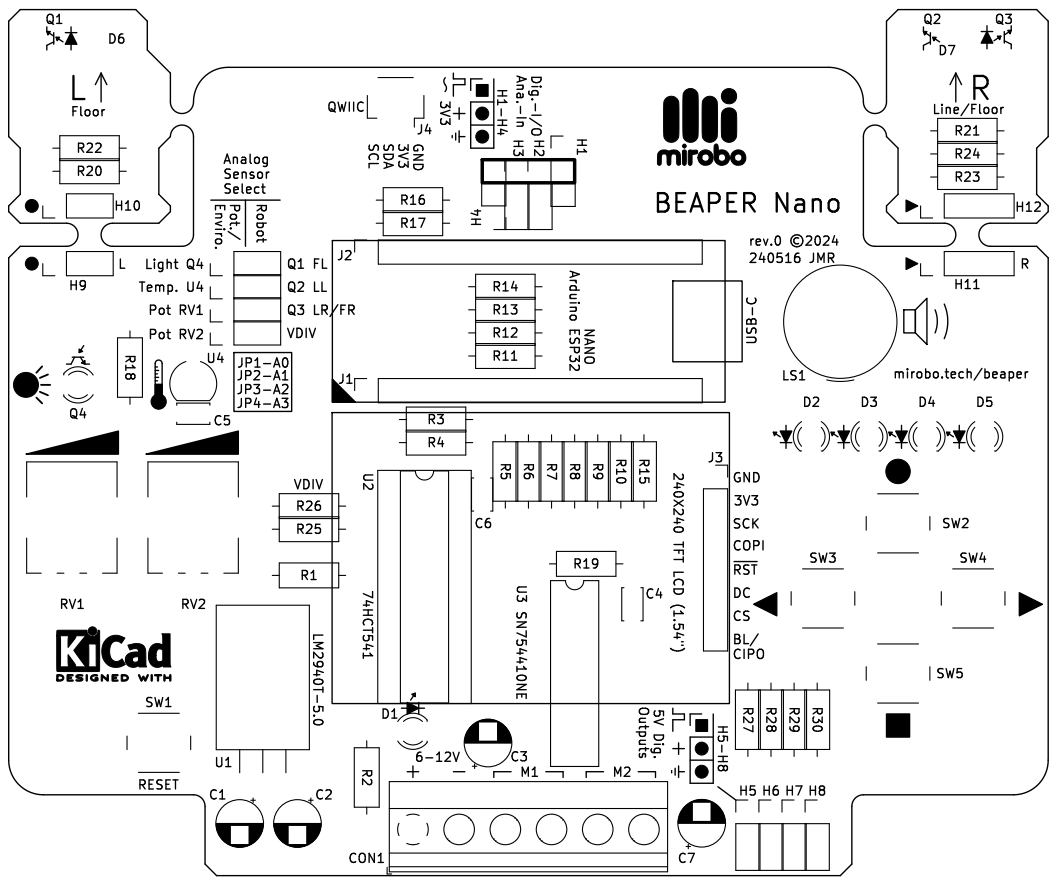
[picture p14: page 1]
