nbourre/ranger_dropin/Beaper-Esp32s3.kicad_pcb

## KiCad design Beaper-Esp32s3.kicad_pcb (2026-10-31)

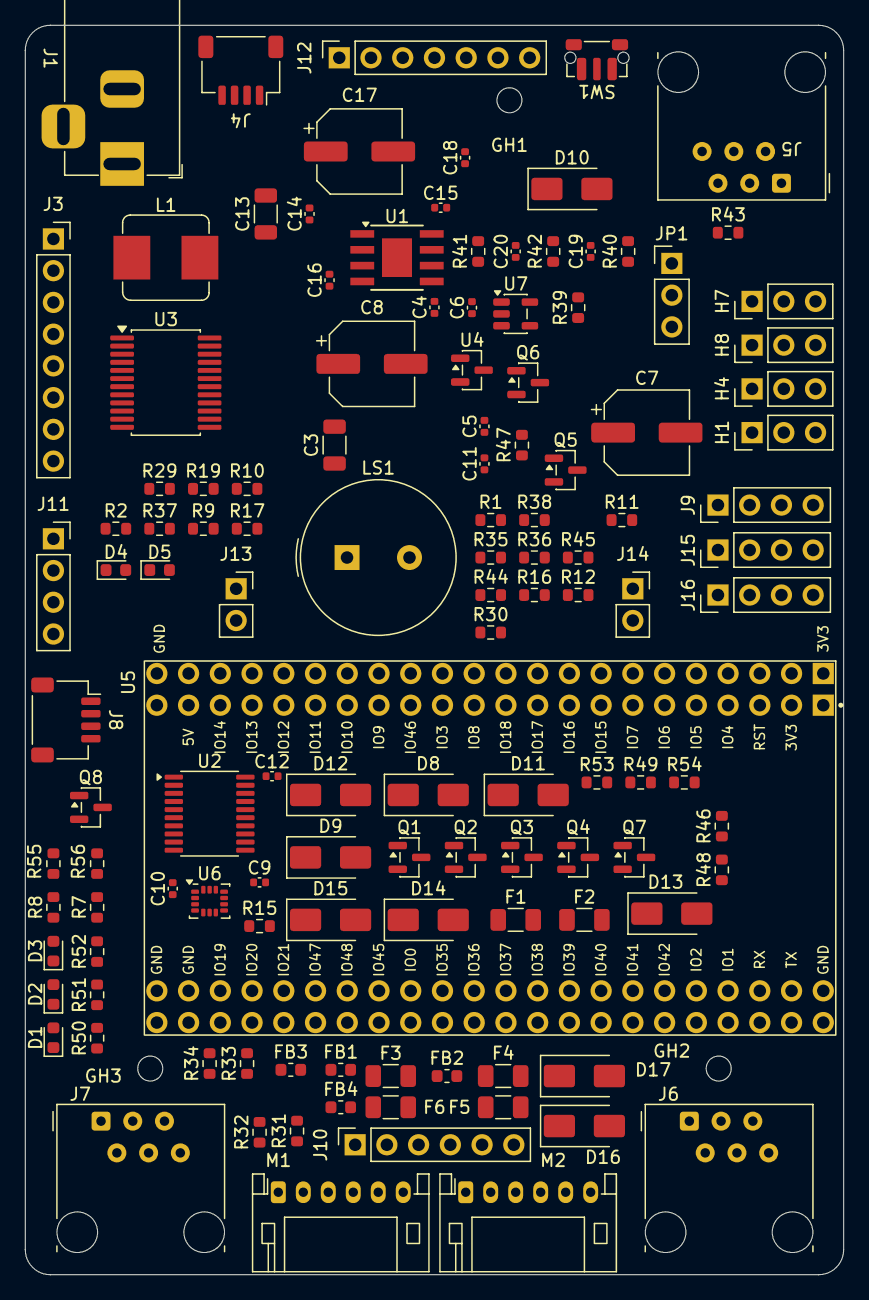
[picture p15: board Beaper-Esp32s3.kicad_pcb from above]

Board: 2 copper layers, 65.5 x 100.0 mm, 127 parts (0 on the bottom side), 89 nets, no tracks yet.

Parts:
C3, C13: 10uF/50V; C_1206_3216Metric
C4, C5, C6, C9, C10, C12, C14, C15, C18: 100nF; C_0402_1005Metric
C7, C8, C17: 470uF/16V; CP_Elec_6.3x7.7
C11: 1uF; C_0402_1005Metric
C16: 10nF; C_0402_1005Metric
C19: 120pF; C_0402_1005Metric
C20: 68pF; C_0402_1005Metric
D1: Vin; LED_0603_1608Metric
D2, D3, D4, D5: LED; LED_0603_1608Metric
D8: SS54; D_SMA
D9: SMAJ13CA; D_SMA
D10, D11, D13: SS34; D_SMA
D12: SMAJ5.0CA; D_SMA
D14, D15, D16, D17: SMAJ12CA; D_SMA
F1: 3.5A; Fuse_1206_3216Metric
F2: 3A; Fuse_1206_3216Metric
F3, F4, F5, F6: 1A PTC; Fuse_1206_3216Metric
FB1, FB2, FB3, FB4: 120R/2A; L_0603_1608Metric
G1: mirobotech_logo; mirobo_logo_10
GH1, GH2, GH3: MountingHole_2mm
H1: A4 (SDA); PinHeader_1x03_P2.54mm_Vertical
H4: A5 (SCL); PinHeader_1x03_P2.54mm_Vertical
H7: A6 (Servo 3); PinHeader_1x03_P2.54mm_Vertical
H8: A7 (Servo 4); PinHeader_1x03_P2.54mm_Vertical
J1: DC jack 5.5x2.1; BarrelJack_Horizontal
J3: Conn_01x08; PinSocket_1x08_P2.54mm_Vertical
J4, J8: QWIIC/JST SH; JST_SH_SM04B-SRSS-TB_1x04-1MP_P1.00mm_Horizontal
J5: RJ25 port A; RJ12_Amphenol_54601-x06_Horizontal
J6: RJ25 port B; RJ12_Amphenol_54601-x06_Horizontal
J7: RJ25 port C; RJ12_Amphenol_54601-x06_Horizontal
J9, J15, J16: I2C (GND 3V3 SCL SDA); PinHeader_1x04_P2.54mm_Vertical
J10: VL53L1X module; PinSocket_1x06_P2.54mm_Vertical
J11: OLED I2C; PinSocket_1x04_P2.54mm_Vertical
J12: PRGB (Auriga panel module); PinSocket_1x07_P2.54mm_Vertical
J13: PG1 (GND support); PinSocket_1x02_P2.54mm_Vertical
J14: PG2 (GND support); PinSocket_1x02_P2.54mm_Vertical
JP1: I2C EXT 3V3/5V; PinHeader_1x03_P2.54mm_Vertical
L1: 6.8uH/4.5A; L_Bourns_SRP7028A_7.3x6.6mm
LS1: Piezo Beeper; Buzzer_TDK_PS1240P02BT_D12.2mm_H6.5mm
M1: Moteur 1 (MHDR1X6); JST_PH_S6B-PH-K_1x06_P2.00mm_Horizontal
M2: Moteur 2 (MHDR1X6); JST_PH_S6B-PH-K_1x06_P2.00mm_Horizontal
Q1, Q2, Q3, Q4, Q5, Q6, Q7, Q8: BSS138; SOT-23
R1, R11, R12, R29, R30: 100; R_0603_1608Metric
R2, R15: 1k0; R_0603_1608Metric
R7, R8, R9, R10: 270; R_0603_1608Metric
R16, R17: 4k7; R_0603_1608Metric
R19, R37, R40, R45, R46, R47, R48, R49, R50, R51, R52, R53, R54, R55, R56: 10k; R_0603_1608Metric
R31, R32, R33, R34: 51; R_0603_1608Metric
R35: 100k; R_0603_1608Metric
R36: 51k; R_0603_1608Metric
R38: 15k; R_0603_1608Metric
R39: 220; R_0603_1608Metric
R41: 1.91k; R_0603_1608Metric
R42: 30k; R_0603_1608Metric
R43, R44: 4.7k; R_0603_1608Metric
SW1: RESET; SW_Push_1P1T-MP_NO_Horizontal_Alps_SKRTLAE010
U1: TPS54331DDA; TI_SO-PowerPAD-8
U2: 74HCT541; TSSOP-20_4.4x6.5mm_P0.65mm
U3: TB6612FNG; SSOP-24_5.3x8.2mm_P0.65mm
U4: MCP9700AT-E/TT; SOT-23
U5: ESP32-S3-DevKitC-1-N16R8; ESP32-S3-DevKitC-1-2x22
U6: LSM6DS3TR-C; LGA-14_3x2.5mm_P0.5mm_LayoutBorder3x4y
U7: 74AHCT1G125; SOT-23-5

Connections:
+3V3: C5.1, C9.1, C10.1, H1.2, H4.2, J3.2, J4.2, J8.2, J9.2, J10.1, J11.2, J15.2, J16.2, JP1.1, M1.3, M2.3, Q1.1, Q2.1, Q3.1, Q4.1, Q5.1, Q6.1, Q7.1, Q8.1, R16.1, R17.1, R45.2, R46.2, R47.2, R48.2, R49.2, R50.2, U4.1, U5.L1 (3V3), U5.L2 (3V3), U6.5, U6.8, U6.12
+5V: C4.1, C6.1, C7.1, C12.1, D11.1 (K), D12.2 (A2), H7.2, H8.2, J12.7, R19.1, U2.20, U3.15, U3.20, U3.23, U5.L21 (5V), U7.5
/5V_P: C17.1, C18.1, D11.2 (A), J5.4, J6.4, J7.4, JP1.3, L1.2, R40.1, R51.1, R52.1, R53.1, R54.1, R55.1, R56.1
/A1: U4.2, U5.R5 (GPIO2)
/A2: J12.3, U5.L4 (GPIO4)
/A3: J12.4, U5.L5 (GPIO5)
/A4/SDA: J4.3, J8.3, J9.4, J10.4, J11.4, J15.4, J16.4, Q1.2, R11.2, R16.2, U2.5, U5.L12 (GPIO8), U6.14
/A5/SCL: J4.4, J8.4, J9.3, J10.3, J11.3, J15.3, J16.3, Q2.2, R12.2, R17.2, U2.4, U5.L15 (GPIO9), U6.13
/A6: U2.3, U5.L6 (GPIO6)
/A7: U2.2, U5.L7 (GPIO7)
/D4: R7.1, U2.6, U5.L9 (GPIO16)
/D5: R8.1, U2.7, U5.L10 (GPIO17)
/D6: R9.1, U2.8, U5.L11 (GPIO18)
/D7: R10.1, U2.9, U5.R18 (GPIO21)
/D8: LS1.1, R15.2, U5.R17 (GPIO47)
/D9: J3.6, Q7.2, R49.1, U5.R10 (GPIO38)
/D10: J3.7, Q8.2, R50.1, U5.L16 (GPIO10)
/D11/COPI: J3.4, U5.L17 (GPIO11)
/D12/CIPO: J3.8, U5.L19 (GPIO13)
/D13/SCK: J3.3, U5.L18 (GPIO12)
/ENC1A: R31.2, U5.R9 (GPIO39)
/ENC1A_H: M1.2, R31.1
/ENC1B: R32.2, U5.R8 (GPIO40)
/ENC1B_H: M1.1, R32.1
/ENC2A: R33.2, U5.R7 (GPIO41)
/ENC2A_H: M2.2, R33.1
/ENC2B: R34.2, U5.R6 (GPIO42)
/ENC2B_H: M2.1, R34.1
/EXT_SCL: J5.1, J6.1, J7.1, Q2.3, R44.2
/EXT_SDA: J5.2, J6.2, J7.2, Q1.3, R43.2
/FB: R40.2, R41.1, U1.5 (VSENSE)
/KEY: J12.2, R38.1
/KEY_GPIO: R37.2, R38.2, U5.L20 (GPIO14)
/M1A: F3.2, M1.6
/M1A_D: D14.2 (A2), FB1.1, U3.1, U3.2
/M1B: F4.2, M1.5
/M1B_D: D15.2 (A2), FB2.1, U3.5, U3.6
/M1_IN1: U2.14, U3.21
/M1_IN2: U2.13, U3.22
/M2A: F5.2, M2.6
/M2A_D: D16.2 (A2), FB3.1, U3.11, U3.12
/M2B: F6.2, M2.5
/M2B_D: D17.2 (A2), FB4.1, U3.7, U3.8
/M2_IN1: U2.12, U3.17
/M2_IN2: U2.11, U3.16
/MOTOR_STBY: R19.2, U3.19
/PA_S1: Q3.2, R45.1, U5.R4 (GPIO1)
/PA_S1_5V: J5.5, Q3.3, R51.2
/PA_S2: Q4.2, R46.1, U5.L8 (GPIO15)
/PA_S2_5V: J5.6, Q4.3, R52.2
/PB_S1: Q5.2, R47.1, U5.R2 (GPIO43/TX)
/PB_S1_5V: J6.5, Q5.3, R53.2
/PB_S2: Q6.2, R48.1, U5.R3 (GPIO44/RX)
/PB_S2_5V: J6.6, Q6.3, R54.2
/PC_S1_5V: J7.5, Q7.3, R55.2
/PC_S2_5V: J7.6, Q8.3, R56.2
/RGB: J12.5, R39.2
/RGB_3V3: U5.R16 (GPIO48), U7.2
/RGB_BUF: R39.1, U7.4
/VBAT: D9.2 (A2), F1.2, F2.1, J1.1
/VI2C: JP1.2, R43.1, R44.1
/VOL_BAT: C11.1, R35.2, R36.1, U5.L13 (GPIO3)
/~RST: J3.5, R1.2, U5.L3 (RST)
GND: C3.2, C4.2, C5.2, C6.2, C7.2, C8.2, C9.2, C10.2, C11.2, C12.2, C13.2, C14.2, C16.2, C17.2, C18.2, C19.2, C20.2, D1.1, D2.1, D3.1, D4.1, D5.1, D9.1 (A1), D10.2 (A), D12.1 (A1), D14.1 (A1), D15.1 (A1), D16.1 (A1), D17.1 (A1), H1.3, H4.3, H7.3, H8.3, J1.2, J3.1, J4.1, J5.3, J6.3, J7.3, J8.1, J9.1, J10.2, J11.1, J12.6, J13.1, J13.2, J14.1, J14.2, J15.1, J16.1, LS1.2, M1.4, M2.4, R15.1, R36.2, R37.1, R41.2, SW1.1, U1.7 (GND), U1.9 (PowerPAD), U2.1, U2.10, U2.19, U3.3, U3.4, U3.9, U3.10, U3.18, U4.3, U5.L22 (GND), U5.R1 (GND), U5.R21 (GND), U5.R22 (GND), U6.1, U6.6, U6.7, U7.1, U7.3
unnamed: C19.1, R42.2
unnamed: D1.2, R2.1
unnamed: D2.2, R7.2
unnamed: D3.2, R8.2
unnamed: D4.2, R9.2
unnamed: D5.2, R10.2
unnamed: D8.2 (A), F1.1
unnamed: C15.2, D10.1 (K), L1.1, U1.8 (PH)
unnamed: D13.2 (A), F2.2
unnamed: C13.1, C14.1, D13.1 (K), U1.2 (VIN)
unnamed: F3.1, FB1.2
unnamed: F4.1, FB2.2
unnamed: F5.1, FB3.2
unnamed: F6.1, FB4.2
unnamed: H1.1, R11.1
unnamed: H4.1, R12.1
unnamed: H7.1, R29.1
unnamed: H8.1, R30.1
unnamed: R1.1, SW1.2
unnamed: C15.1, U1.1 (BOOT)
unnamed: C20.1, R42.1, U1.6 (COMP)
unnamed: C16.1, U1.4 (SS/TR)
unnamed: R30.2, U2.18
unnamed: R29.2, U2.17
VCC: C3.1, C8.1, D8.1 (K), J12.1, R2.2, R35.1, U3.13, U3.14, U3.24
