nbourre/ranger_dropin/BEAPER-Nano.kicad_pcb

## KiCad design BEAPER-Nano.kicad_pcb (2026-10-19)

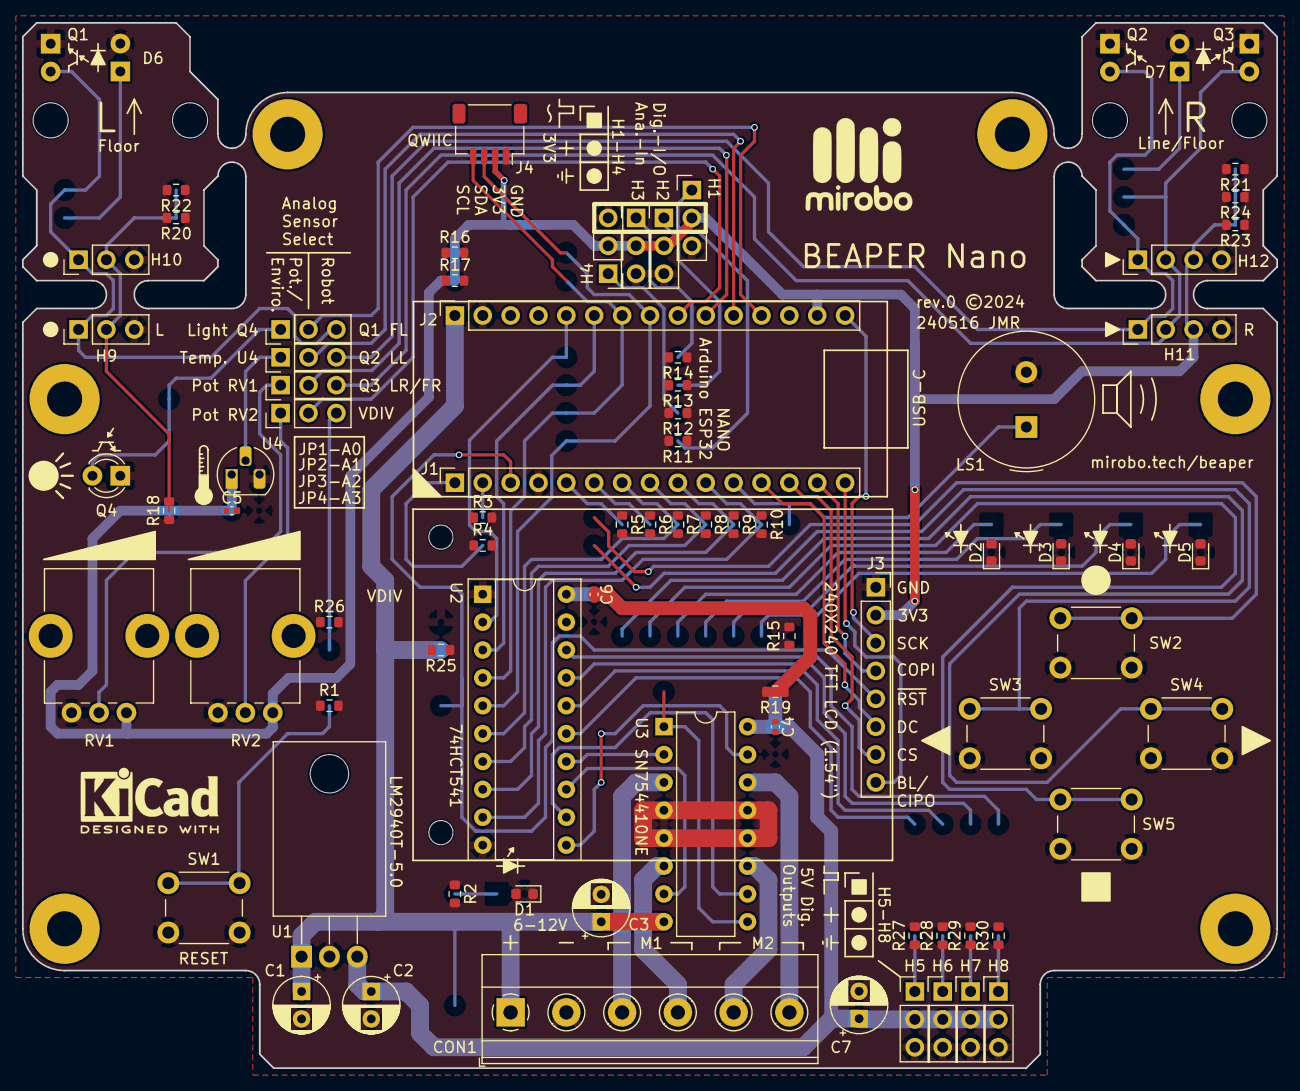
[picture p16: board BEAPER-Nano.kicad_pcb from above]

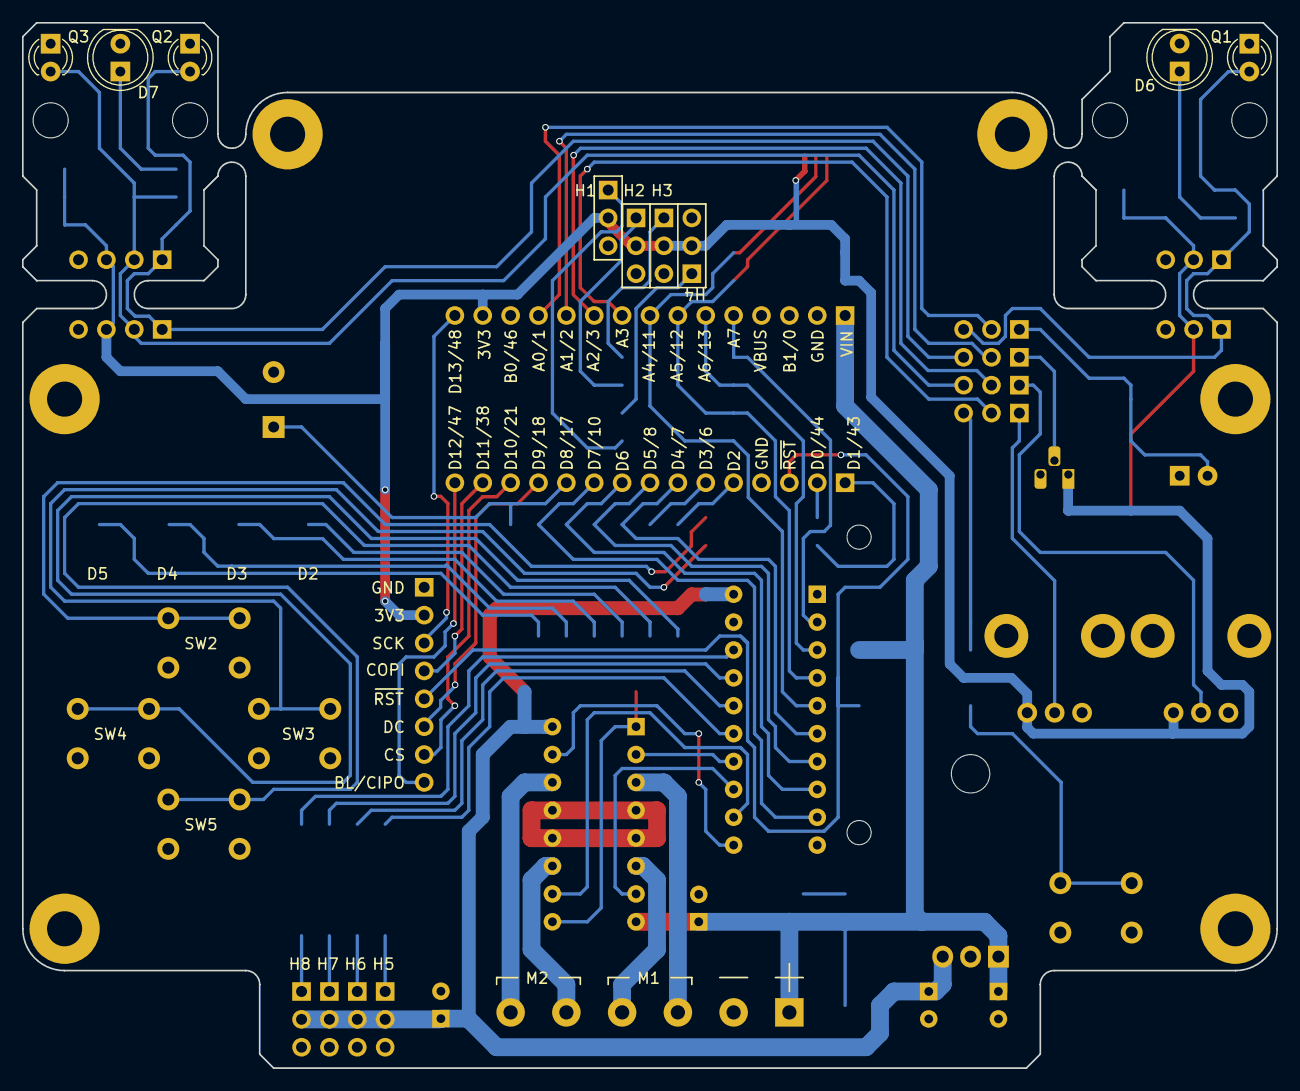
[picture p17: board BEAPER-Nano.kicad_pcb from below]

Board: 2 copper layers, 114.3 x 95.2 mm, 82 parts (5 on the bottom side), 68 nets.

Parts:
C1, C2, C3, C7: 10uF; CP_Radial_D5.0mm_P2.50mm
C4, C5, C6: 100nF; C_0402_1005Metric
CON1: Phoenix 1729160; TerminalBlock_Phoenix_MKDS-1,5-6-5.08_1x06_P5.08mm_Horizont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
D1: Vin; LED_0603_1608Metric
D2, D3, D4, D5: LED; LED_0603_1608Metric
D6, D7: OED-EL-1L2; LED_D5.0mm_Clear
G1: mirobotech_logo; mirobo_logo_10
H1: A4 (SDA); PinHeader_1x03_P2.54mm_Vertical
H2: A6 (SONAR TRIG); PinHeader_1x03_P2.54mm_Vertical
H3: A7 (SONAR ECHO); PinHeader_1x03_P2.54mm_Vertical
H4: A5 (SCL); PinHeader_1x03_P2.54mm_Vertical
H5: A4 (Servo 1); PinHeader_1x03_P2.54mm_Vertical
H6: A5 (Servo 2); PinHeader_1x03_P2.54mm_Vertical
H7: A6 (Servo 3); PinHeader_1x03_P2.54mm_Vertical
H8: A7 (Servo 4); PinHeader_1x03_P2.54mm_Vertical
H9, H10: Conn_01x03_Male; PinHeader_1x03_P2.54mm_Vertical
H11, H12: Conn_01x04_Pin; PinHeader_1x04_P2.54mm_Vertical
J1: Digital; PinSocket_1x15_P2.54mm_Vertical
J2: Analog; PinSocket_1x15_P2.54mm_Vertical
J3: Conn_01x08; PinSocket_1x08_P2.54mm_Vertical
J4: QWIIC/JST SH; JST_SH_SM04B-SRSS-TB_1x04-1MP_P1.00mm_Horizontal
JP1, JP2: ALS/LFS; PinHeader_1x03_P2.54mm_Vertical
JP3, JP4: POT/VDIV; PinHeader_1x03_P2.54mm_Vertical
LS1: Piezo Beeper; Buzzer_TDK_PS1240P02BT_D12.2mm_H6.5mm
Q1, Q2, Q3: LTR-4206E; LED_D3.0mm_IRBlack
Q4: TEPT4400; LED_D3.0mm_Clear
R1, R11, R12, R13, R14, R20, R21, R27, R28, R29, R30: 100; R_0603_1608Metric
R2, R3, R4, R5, R6, R15: 1k0; R_0603_1608Metric
R7, R8, R9, R10: 270; R_0603_1608Metric
R16, R17, R18, R22, R23, R24: 4k7; R_0603_1608Metric
R19: 10k; R_0603_1608Metric
R25: 5.62k-1%; R_0603_1608Metric
R26: 1.37k-1%; R_0603_1608Metric
RV1, RV2: 10k; Potentiometer_Bourns_PTV09A-1_Single_Vertical
SW1: RESET; SW_PUSH_6mm
SW2, SW3, SW4, SW5: SW_Push; SW_PUSH_6mm
U1: LM2940T-5.0; TO-220-3_Horizontal_TabDown
U2: 74HCT541; DIP-20_W7.62mm_Socket
U3: SN754410NE; DIP-16_W7.62mm
U4: MCP9700A-E/TO; TO-92_HandSolder

Connections:
+3V3: C5.1, H1.2, H2.2, H3.2, H4.2, H9.2, H10.2, H11.3, H12.3, J2.14, J3.2, J4.2, R16.1, R17.1, R18.1, R20.1, R21.1, R22.1, R23.1, R24.1, RV1.1, RV2.1, U4.1 (V_{DD})
+5V: C2.1, C4.1, C6.1, C7.1, H5.2, H6.2, H7.2, H8.2, R19.1, U1.3 (VO), U2.20 (VCC), U3.16 (VCC1)
/A0: J2.12, JP1.2 (C)
/A1: J2.11, JP2.2 (C)
/A2: J2.10, JP3.2 (C)
/A3: J2.9, JP4.2 (C)
/A4/SDA: J2.8, J4.3, R11.2, R16.2, U2.5 (A3)
/A5/SCL: J2.7, J4.4, R12.2, R17.2, U2.4 (A2)
/A6: J2.6, R13.2, U2.3 (A1)
/A7: J2.5, R14.2, U2.2 (A0)
/D0/RX0: J1.2, R3.1
/D1/TX0: J1.1, R4.1
/D2: J1.5, R5.1
/D3: J1.6, R6.1
/D4: J1.7, R7.1, U2.6 (A4)
/D5: J1.8, R8.1, U2.7 (A5)
/D6: J1.9, R9.1, U2.8 (A6)
/D7: J1.10, R10.1, U2.9 (A7)
/D8: J1.11, LS1.1, R15.2
/D9: J1.12, J3.6
/D10: J1.13, J3.7
/D11/COPI: J1.14, J3.4
/D12/CIPO: J1.15, J3.8
/D13/SCK: J2.15, J3.3
/Q1: H9.1, H10.1, JP1.3 (B), Q1.1 (C), R22.2
/Q2: H11.1, H12.1, JP2.3 (B), Q2.1 (C), R23.2
/Q3: H11.2, H12.2, JP3.3 (B), Q3.1 (C), R24.2
/~RST: J1.3, J3.5, R1.2
GND: C1.2, C2.2, C3.2, C4.2, C5.2, C6.2, C7.2, CON1.2, D1.1 (K), D2.1 (K), D3.1 (K), D4.1 (K), D5.1 (K), D6.1 (K), D7.1 (K), H1.3, H2.3, H3.3, H4.3, H5.3, H6.3, H7.3, H8.3, H9.3, H10.3, H11.4, H12.4, J1.4, J2.2, J3.1, J4.1, LS1.2, Q1.2 (E), Q2.2 (E), Q3.2 (E), Q4.2 (E), R15.1, R26.2, RV1.3, RV2.3, SW1.1, SW2.1, SW3.1, SW4.1, SW5.1, U1.2 (GND), U2.1 (G1), U2.10 (GND), U2.19 (G2), U3.4 (GND), U3.5 (GND), U3.12 (GND), U3.13 (GND), U4.3 (GND)
unnamed: CON1.3, U3.3 (1Y)
unnamed: CON1.4, U3.6 (2Y)
unnamed: CON1.5, U3.11 (3Y)
unnamed: CON1.6, U3.14 (4Y)
unnamed: D1.2 (A), R2.1
unnamed: D2.2 (A), R7.2
unnamed: D3.2 (A), R8.2
unnamed: D4.2 (A), R9.2
unnamed: D5.2 (A), R10.2
unnamed: D6.2 (A), R20.2
unnamed: D7.2 (A), R21.2
unnamed: H1.1, R11.1
unnamed: H2.1, R13.1
unnamed: H3.1, R14.1
unnamed: H4.1, R12.1
unnamed: H5.1, R27.1
unnamed: H6.1, R28.1
unnamed: H7.1, R29.1
unnamed: H8.1, R30.1
unnamed: JP1.1 (A), Q4.1 (C), R18.2
unnamed: JP2.1 (A), U4.2 (V_{OUT})
unnamed: JP3.1 (A), RV1.2
unnamed: JP4.1 (A), RV2.2
unnamed: JP4.3 (B), R25.2, R26.1
unnamed: R1.1, SW1.2
unnamed: R3.2, SW2.2
unnamed: R4.2, SW3.2
unnamed: R5.2, SW4.2
unnamed: R6.2, SW5.2
unnamed: R30.2, U2.18 (Y0)
unnamed: R29.2, U2.17 (Y1)
unnamed: R28.2, U2.16 (Y2)
unnamed: R27.2, U2.15 (Y3)
unnamed: U2.14 (Y4), U3.2 (1A)
unnamed: U2.13 (Y5), U3.7 (2A)
unnamed: U2.12 (Y6), U3.10 (3A)
unnamed: U2.11 (Y7), U3.15 (4A)
unnamed: R19.2, U3.1 (1,2EN), U3.9 (3,4EN)
VCC: C1.1, C3.1, CON1.1, J2.1, R2.2, R25.1, U1.1 (VI), U3.8 (VCC2)
