nbourre/ranger_dropin/(commit log)

2026-10-18 Changement des pièces pour du smd
2026-10-19 Ajout du pinmap de l'Auriga
2026-10-20 update avec les modules principaux
2026-10-20 Fusible de protection et datasheets
2026-10-21 Ajout des jst-ph, ajustement des positions, headers i2c
2026-10-22 Ajout de tâches
2026-10-28 Ajout pour diminuer le nombre de pièces
2026-10-29 Fin de journée et mémoire à jour.
2026-10-31 wip : placement des pièces
