nbourre/ranger_dropin/(notices)

Notices in the files:
Beaper-Esp32s3.kicad_sch:
©2024 mirobo.tech
BEAPER-Nano.kicad_pcb:
rev.0 ©2024
